SirCrashAlot79/lathe_dro/Case lid.stl

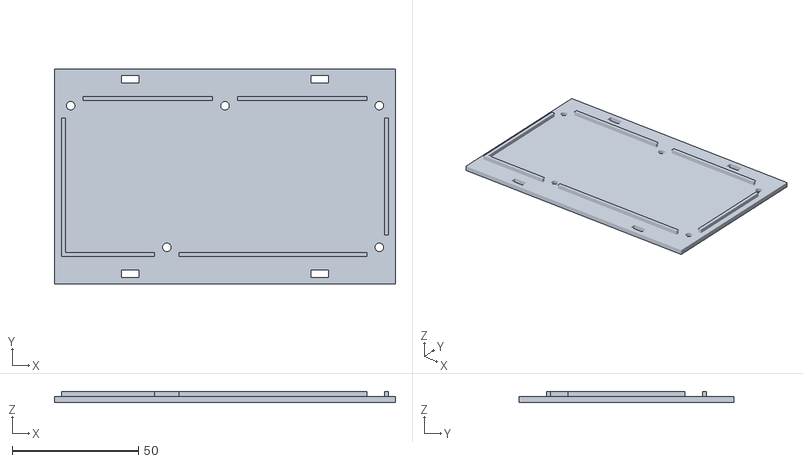
[picture p5: CAD file, 2026-10-19]
Case lid.stl
134.8 x 84.8 x 4.40
