SirCrashAlot79/lathe_dro/Right frame.stl

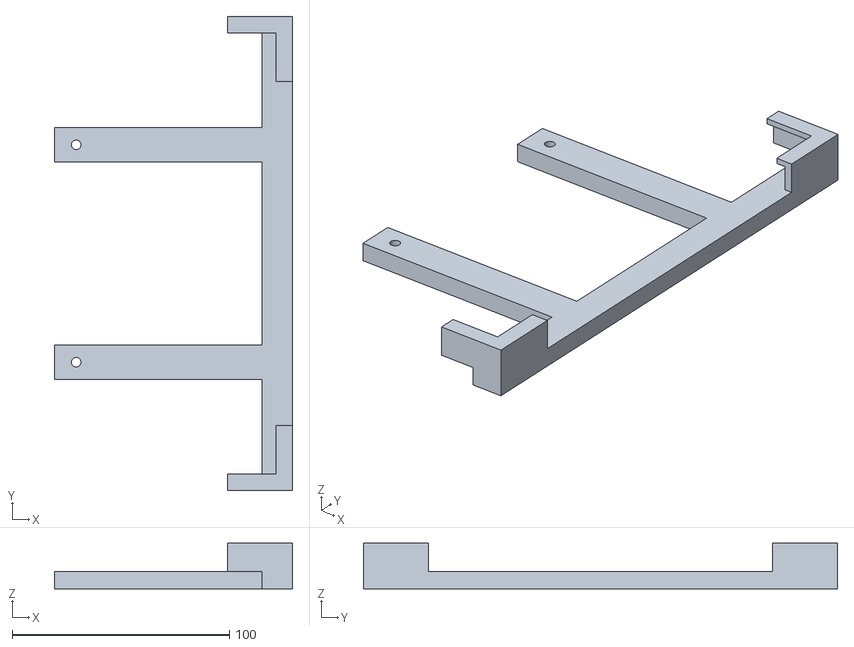
[picture p6: CAD file, 2026-10-19]
Right frame.stl
109.5 x 218.0 x 21.0
