SirCrashAlot79/lathe_dro/Case base.stl

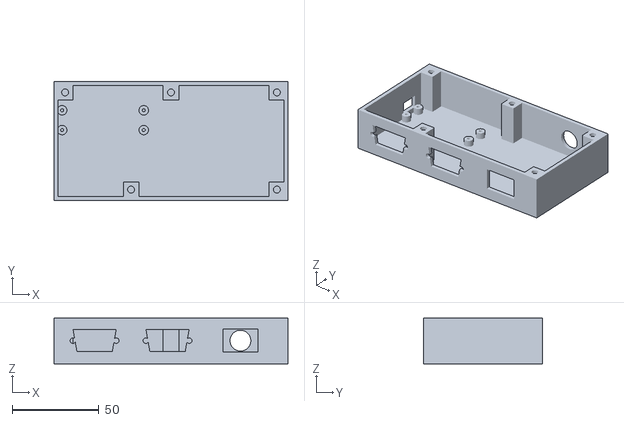
[picture p7: CAD file, 2026-10-19]
Case base.stl
134.8 x 68.8 x 26.4
