SirCrashAlot79/lathe_dro/(list of files, cad)

Other CAD files:
Left frame.stl
