SirCrashAlot79/lathe_dro/raspberry_pi_dro/lathe_dro_pro.py

import argparse
import json
import math
from pathlib import Path
import subprocess
import sys
import pygame
import serial
from serial.tools import list_ports

# --- CONFIGURATION INITIALIZATION ---
PULSES_PER_INCH = 25400.0
DEMO_MODE = False
TOOL_OFFSETS_FILE = Path(__file__).with_name("tool_offsets.json")
SCALE_CALIBRATION_FILE = Path(__file__).with_name("scale_calibration.json")
MILL_SCALE_CALIBRATION_FILE = Path(__file__).with_name("mill_scale_calibration.json")
MILL_SUB_DATUMS_FILE = Path(__file__).with_name("mill_sub_datums.json")
BOOT_IMAGE_FILE = Path(__file__).with_name("assets") / "south_bend_badge.png"
STUD_GEAR = 40
THREADING_CHART = (
    ("A", (4, 4.5, 5, 5.5, 5.75, 6, 6.5, 6.75, 7, 7.5)),
    ("B", (8, 9, 10, 11, 11.5, 12, 13, 13.5, 14, 15)),
    ("C", (16, 18, 20, 22, 23, 24, 26, 27, 28, 30)),
    ("D", (32, 36, 40, 44, 46, 48, 52, 54, 56, 60)),
    ("E", (64, 72, 80, 88, 92, 96, 104, 108, 112, 120)),
    ("F", (128, 144, 160, 176, 184, 192, 208, 216, 224, 240)),
    ("G", (256, 288, 320, 352, 368, 384, 416, 432, 448, 480)),
)
HSS_SURFACE_SPEED_SFM = {
    "Mild steel": 80,
    "Aluminum": 200,
    "Stainless steel": 50,
    "Cast iron": 60,
}
SPINDLE_SPEED_STEPS = {
    ("BELT DRIVE", "LOW RANGE"): (240, 410, 715),
    ("BACK GEAR", "LOW RANGE"): (50, 78, 135),
    ("BELT DRIVE", "HIGH RANGE"): (460, 780, 1365),
    ("BACK GEAR", "HIGH RANGE"): (90, 155, 265),
}


def parse_serial_packet(line):
    """Parse separate lathe/mill counts or a legacy shared-axis packet."""
    if not line.strip():
        return 0, 0, 0, 0, 0, 0

    values = {}
    for field in line.strip().split(","):
        key, value = field.split(":", 1)
        values[key.strip().upper()] = int(value.strip())

    if {"LX", "LZ", "MX", "MY", "MZ", "RPM"}.issubset(values):
        return (
            values["LX"],
            values["LZ"],
            values["MX"],
            values["MY"],
            values["MZ"],
            values["RPM"],
        )

    try:
        x_count = values["X"]
        z_count = values["Z"]
        y_count = values.get("Y", 0)
        rpm_count = values["RPM"]
    except KeyError as error:
        raise ValueError(f"Missing {error.args[0]} field in serial packet") from error
    return x_count, z_count, x_count, y_count, z_count, rpm_count


def counts_for_machine(machine, lathe_counts, mill_counts):
    if machine == "lathe":
        return lathe_counts[0], 0, lathe_counts[1]
    if machine == "mill":
        return mill_counts
    raise ValueError(f"Unknown machine: {machine}")


def find_pico_port():
    for port in list_ports.comports():
        description = (port.description or "").lower()
        if port.vid == 0x2E8A or "pico" in description:
            return port.device
    return None


def read_serial_packets(connection, pending_data):
    if connection is None or not connection.in_waiting:
        return pending_data, None

    pending_data += connection.read(connection.in_waiting).decode("ascii", errors="ignore")
    latest_packet = None
    while "\n" in pending_data:
        line, pending_data = pending_data.split("\n", 1)
        if not line.strip():
            continue
        try:
            latest_packet = parse_serial_packet(line)
        except (ValueError, KeyError):
            continue
    if len(pending_data) > 1024:
        pending_data = pending_data[-1024:]
    return pending_data, latest_packet


def open_pico_connection(port, baudrate):
    selected_port = port or find_pico_port()
    if selected_port is None:
        return None, "Pico not found; use --port or --demo"
    try:
        return serial.Serial(selected_port, baudrate=baudrate, timeout=0), f"Connected: {selected_port}"
    except serial.SerialException as error:
        return None, f"Serial connection failed: {error}"


def load_tool_touch_positions(path=TOOL_OFFSETS_FILE):
    try:
        data = json.loads(path.read_text(encoding="utf-8"))
    except (OSError, json.JSONDecodeError):
        return {}
    if not isinstance(data, dict):
        return {}

    positions = {}
    for tool_id, coordinates in data.items():
        try:
            tool_id = int(tool_id)
            x_position = int(coordinates["x"])
            z_position = int(coordinates["z"])
        except (KeyError, TypeError, ValueError):
            continue
        if 1 <= tool_id <= 9:
            positions[tool_id] = (x_position, z_position)
    return positions


def save_tool_touch_positions(path, positions):
    data = {
        str(tool_id): {"x": x_position, "z": z_position}
        for tool_id, (x_position, z_position) in positions.items()
    }
    path.write_text(json.dumps(data, indent=2) + "\n", encoding="utf-8")


def scale_compensation_for_travel(known_distance, count_delta,
                                  metric=False, pulses_per_inch=PULSES_PER_INCH):
    """Return the correction factor from a measured linear-axis move."""
    values = (known_distance, count_delta, pulses_per_inch)
    if not all(math.isfinite(value) for value in values):
        raise ValueError("calibration values must be finite numbers")
    if known_distance <= 0 or count_delta == 0 or pulses_per_inch <= 0:
        raise ValueError("distance, count change, and counts per inch must be positive")

    distance_inches = known_distance / 25.4 if metric else known_distance
    return distance_inches * pulses_per_inch / abs(count_delta)


def load_scale_calibration(path=SCALE_CALIBRATION_FILE):
    factors = {"x": 1.0, "y": 1.0, "z": 1.0}
    try:
        data = json.loads(path.read_text(encoding="utf-8"))
    except (OSError, json.JSONDecodeError):
        return factors
    if not isinstance(data, dict):
        return factors

    for axis in factors:
        try:
            factor = float(data.get(axis, factors[axis]))
        except (TypeError, ValueError):
            continue
        if math.isfinite(factor) and factor > 0:
            factors[axis] = factor
    return factors


def save_scale_calibration(path, factors):
    data = {axis: float(factors[axis]) for axis in ("x", "y", "z")}
    path.write_text(json.dumps(data, indent=2) + "\n", encoding="utf-8")


def set_scale_compensation(axis, factor, path=SCALE_CALIBRATION_FILE):
    """Persist a valid per-axis correction and update the live display factor."""
    global x_linear_error_comp, y_linear_error_comp, z_linear_error_comp
    global scale_calibration_factors

    axis = axis.upper()
    if axis not in ("X", "Y", "Z") or not math.isfinite(factor) or factor <= 0:
        raise ValueError("axis must be X, Y, or Z and compensation must be positive")
    updated_factors = dict(scale_calibration_factors)
    updated_factors[axis.lower()] = float(factor)
    save_scale_calibration(path, updated_factors)
    scale_calibration_factors = updated_factors
    if axis == "X":
        x_linear_error_comp = updated_factors["x"]
    elif axis == "Y":
        y_linear_error_comp = updated_factors["y"]
    else:
        z_linear_error_comp = updated_factors["z"]


def set_mill_scale_compensation(axis, factor, path=MILL_SCALE_CALIBRATION_FILE):
    """Persist independent per-axis mill calibration."""
    global mill_scale_calibration_factors

    axis = axis.lower()
    if axis not in ("x", "y", "z") or not math.isfinite(factor) or factor <= 0:
        raise ValueError("axis must be X, Y, or Z and compensation must be positive")
    updated_factors = dict(mill_scale_calibration_factors)
    updated_factors[axis] = float(factor)
    save_scale_calibration(path, updated_factors)
    mill_scale_calibration_factors = updated_factors


def mill_preset_origin(count, preset_value, compensation, metric=False,
                       direction=1, pulses_per_inch=PULSES_PER_INCH):
    """Return the raw count origin that produces a requested mill coordinate."""
    if direction not in (-1, 1):
        raise ValueError("axis direction must be 1 or -1")
    values = (count, preset_value, compensation, pulses_per_inch)
    if not all(math.isfinite(value) for value in values):
        raise ValueError("preset and calibration values must be finite")
    if compensation <= 0 or pulses_per_inch <= 0:
        raise ValueError("calibration factor and counts per inch must be positive")

    distance_inches = preset_value / 25.4 if metric else preset_value
    preset_counts = round(distance_inches * pulses_per_inch / compensation)
    return int(count) - direction * preset_counts


def mill_half_origin(count, origin):
    """Shift a mill axis origin so the current coordinate reads half its value."""
    return int(count) - round((int(count) - int(origin)) / 2)


def load_mill_sub_datums(path=MILL_SUB_DATUMS_FILE):
    try:
        data = json.loads(path.read_text(encoding="utf-8"))
    except FileNotFoundError:
        return {}
    except json.JSONDecodeError as error:
        raise ValueError("Sub-datum file contains invalid JSON") from error

    if not isinstance(data, dict):
        raise ValueError("Sub-datum file must contain an object")

    datums = {}
    for name, coordinates in data.items():
        if not isinstance(name, str) or not name or not isinstance(coordinates, dict):
            raise ValueError("Each sub-datum must have a name and X/Y/Z coordinates")
        if set(coordinates) != {"X", "Y", "Z"}:
            raise ValueError(f"Sub-datum {name} must contain X, Y, and Z")
        if any(not isinstance(coordinates[axis], int) for axis in ("X", "Y", "Z")):
            raise ValueError(f"Sub-datum {name} coordinates must be integer counts")
        datums[name] = dict(coordinates)
    return datums


def save_mill_sub_datums(path, datums):
    for name, coordinates in datums.items():
        if (not name or set(coordinates) != {"X", "Y", "Z"}
                or any(not isinstance(coordinates[axis], int) for axis in ("X", "Y", "Z"))):
            raise ValueError("Sub-datums require a name and integer X/Y/Z counts")
    path.write_text(json.dumps(datums, indent=2) + "\n", encoding="utf-8")


def tool_x_offset_to_counts(offset, metric=False, diameter_mode=False,
                            linear_error_comp=1.0, pulses_per_inch=PULSES_PER_INCH):
    """Convert a displayed, signed X tool offset to raw encoder counts."""
    values = (offset, linear_error_comp, pulses_per_inch)
    if not all(math.isfinite(value) for value in values):
        raise ValueError("tool offset and calibration values must be finite")
    if linear_error_comp <= 0 or pulses_per_inch <= 0:
        raise ValueError("calibration factor and counts per inch must be positive")

    radial_distance = offset / 2.0 if diameter_mode else offset
    distance_inches = radial_distance / 25.4 if metric else radial_distance
    return round(distance_inches * pulses_per_inch / linear_error_comp)


def tool_offset_for(tool_id, positions):
    reference = positions.get(1)
    tool_position = positions.get(tool_id)
    if reference is None or tool_position is None:
        return None
    return tool_position[0] - reference[0], tool_position[1] - reference[1]


def tool_corrected_x_count(x_pulses, tool_id, positions):
    offset = tool_offset_for(tool_id, positions)
    if offset is None:
        return None
    return x_pulses - offset[0]


def tool_position_with_manual_x_offset(tool_id, offset_counts, positions):
    """Build a tool's count position from its signed offset to the T-1 master."""
    if not isinstance(tool_id, int) or not 2 <= tool_id <= 9:
        raise ValueError("manual X offsets require a tool ID from T-2 through T-9")
    master_position = positions.get(1)
    if master_position is None:
        raise ValueError("capture T-1 master reference first")
    current_position = positions.get(tool_id)
    z_count = current_position[1] if current_position is not None else master_position[1]
    return master_position[0] + int(offset_counts), z_count

if __name__ == "__main__":
    argument_parser = argparse.ArgumentParser(description="Lathe and mill digital readout")
    argument_parser.add_argument("--port", help="Pico USB serial port, for example /dev/ttyACM0")
    argument_parser.add_argument("--baud", type=int, default=115200)
    argument_parser.add_argument("--demo", action="store_true", help="Use simulated readings")
    display_group = argument_parser.add_mutually_exclusive_group()
    display_group.add_argument("--fullscreen", dest="fullscreen", action="store_true")
    display_group.add_argument("--windowed", dest="fullscreen", action="store_false")
    argument_parser.set_defaults(fullscreen=sys.platform.startswith("linux"))
    arguments = argument_parser.parse_args()

    pygame.init()
    if arguments.fullscreen:
        display_screen = pygame.display.set_mode((0, 0), pygame.FULLSCREEN)
    else:
        display_screen = pygame.display.set_mode((1280, 720))
    pygame.display.set_caption("South Bend Lathe / Grizzly G0704 Mill DRO")
    width, height = 1280, 720
    screen = pygame.Surface((width, height))
    display_width, display_height = display_screen.get_size()
    ui_scale = min(display_width / width, display_height / height)
    viewport_width = int(width * ui_scale)
    viewport_height = int(height * ui_scale)
    viewport_left = (display_width - viewport_width) // 2
    viewport_top = (display_height - viewport_height) // 2
    font_large = pygame.font.SysFont("courier", int(height * 0.13), bold=True)
    font_medium = pygame.font.SysFont("sans", int(height * 0.05), bold=True)
    font_small = pygame.font.SysFont("sans", int(height * 0.032))
    font_button = pygame.font.SysFont("sans", int(height * 0.027))
    boot_logo = pygame.image.load(BOOT_IMAGE_FILE).convert_alpha()
    boot_logo_width = 260
    boot_logo_height = round(boot_logo_width * boot_logo.get_height() / boot_logo.get_width())
    boot_logo = pygame.transform.smoothscale(
        boot_logo, (boot_logo_width, boot_logo_height)
    )
else:
    display_screen = None
    screen = None
    width, height = 1280, 720
    ui_scale = 1.0
    viewport_left = 0
    viewport_top = 0

# --- THEME STYLING ---
BLACK = (11, 15, 17)
GREY = (20, 27, 29)
MED_GREY = (31, 40, 42)
LIGHT_GREY = (82, 96, 98)
CYAN = (95, 190, 202)
YELLOW = (235, 174, 72)
WHITE = (225, 230, 226)
GREEN = (137, 194, 132)
MAGENTA = (78, 155, 166)
RED = (208, 78, 68)


def draw_industrial_background(target, target_width, target_height):
    target.fill(BLACK)
    for y in range(28, target_height - 12, 32):
        pygame.draw.line(target, (15, 20, 22), (0, y), (target_width, y), 1)
    pygame.draw.rect(target, (25, 33, 35), (0, 0, target_width, 12))
    pygame.draw.line(target, YELLOW, (0, 12), (target_width, 12), 2)
    pygame.draw.line(target, LIGHT_GREY, (0, target_height - 10), (target_width, target_height - 10), 2)
    pygame.draw.rect(target, (7, 10, 12), (0, target_height - 8, target_width, 8))
    pygame.draw.line(target, (48, 60, 62), (14, 20), (14, target_height - 20), 2)


def wrap_text(text, font, max_width):
    lines = []
    for paragraph in text.splitlines() or [""]:
        current_line = ""
        for word in paragraph.split():
            candidate = word if not current_line else f"{current_line} {word}"
            if font.size(candidate)[0] <= max_width:
                current_line = candidate
                continue
            if current_line:
                lines.append(current_line)
                current_line = ""
            if font.size(word)[0] <= max_width:
                current_line = word
                continue
            fragment = ""
            for character in word:
                if fragment and font.size(fragment + character)[0] > max_width:
                    lines.append(fragment)
                    fragment = character
                else:
                    fragment += character
            current_line = fragment
        lines.append(current_line)
    return lines


def draw_wrapped_text(target, text, font, color, position, max_width, line_gap=3):
    x_position, y_position = position
    for line in wrap_text(text, font, max_width):
        surface = font.render(line, True, color)
        target.blit(surface, (x_position, y_position))
        y_position += surface.get_height() + line_gap
    return y_position


def font_small_rect(font, text, rect):
    return font.render(text, True, WHITE).get_rect(center=rect.center)


def screen_text_rect(font, text, rect):
    return font.render(text, True, BLACK).get_rect(center=rect.center)


def draw_choice_button(screen, rect, label, font):
    pygame.draw.rect(screen, MED_GREY, rect)
    pygame.draw.rect(screen, WHITE, rect, 2)
    screen.blit(font.render(label, True, WHITE), font_small_rect(font, label, rect))


def draw_clear_button(screen, rect, font):
    draw_choice_button(screen, rect, "CLEAR ACTIVE FIELD", font)


def draw_numeric_sign_button(screen, font):
    draw_choice_button(screen, NUMERIC_SIGN_BUTTON, "± SIGN", font)


def draw_back_button(screen, rect, font):
    pygame.draw.rect(screen, RED, rect)
    pygame.draw.rect(screen, WHITE, rect, 2)
    screen.blit(font.render("BACK", True, WHITE), font_small_rect(font, "BACK", rect))


# --- APP STATES ---
STATE_MAIN_DRO = 0
STATE_SETUP_MENU = 1
STATE_TOOL_SETUP = 2
STATE_BOOT = 3
STATE_TAPER = 4
STATE_THREAD = 5
STATE_SPEED = 6
STATE_COORD = 7
STATE_BORING = 8
STATE_POWER_CONFIRM = 9
STATE_MACHINE_SELECT = 10
STATE_MILL_DRO = 11
STATE_MILL_PRESET = 12
STATE_MILL_TOOLS = 13
STATE_MILL_CUTTER_COMP = 14
STATE_MILL_CALCULATOR = 15
STATE_MILL_DATUMS = 16
BOOT_DURATION_MS = 2500
current_state = STATE_BOOT
setup_return_state = STATE_MAIN_DRO

# --- SYSTEM & CALIBRATION CALCULATION REGISTERS ---
lathe_x_pulses, lathe_z_pulses = 0, 0
mill_x_pulses, mill_y_pulses, mill_z_pulses = 0, 0, 0
x_pulses, y_pulses, z_pulses, rpm = 0, 0, 0, 0
selected_machine = "lathe"
x_abs_zero, y_abs_zero, z_abs_zero = 0, 0, 0
x_inc_zero, y_inc_zero, z_inc_zero = 0, 0, 0
mill_abs_zero = {"X": 0, "Y": 0, "Z": 0}
mill_work_zero = {"X": 0, "Y": 0, "Z": 0}
mill_inc_zero = {"X": 0, "Y": 0, "Z": 0}
mill_sub_datums = {}
mill_active_sub_datum = "WORK"
mill_datum_slot = 1
mill_datum_status = ""
mill_datum_file_status = ""
mill_calculator_mode = "STANDARD"
mill_calculator_operation = "+"
mill_calculator_values = {"first": "", "second": ""}
mill_calculator_status = ""
mill_calculator_function_index = 0
MILL_CALCULATOR_FUNCTIONS = ("+", "-", "*", "/", "SIN", "COS", "TAN", "ASIN", "ACOS", "ATAN")
mill_cutter_side = "LEFT"
mill_cutter_values = {"x": "", "y": "", "diameter": "", "angle": ""}
mill_cutter_active_field = "x"
mill_calculator_active_field = "first"
mill_calculator_operation_index = 0
tool_touch_positions = load_tool_touch_positions()
manual_tool_x_offset_text = ""
manual_tool_x_offset_tool_id = None
manual_tool_x_offset_sign = 1
is_diameter_mode = True
is_metric = False
is_abs_mode = True
mill_is_abs_mode = True
current_tool_id = 1
operation_mode = "TURNING"
boring_initial_diameter = ""
boring_start_x_counts = None
boring_start_tool_id = None
boring_start_tool_offset = None
boring_direction = 1
boring_metric = False
boring_status = ""

# User Adjustable Parameters via Setup Panel
resolution_tier = 0.0005     # Toggles: 0.0001, 0.0005, 0.0010
scale_calibration_factors = load_scale_calibration()
x_linear_error_comp = scale_calibration_factors["x"]
y_linear_error_comp = scale_calibration_factors["y"]
z_linear_error_comp = scale_calibration_factors["z"]
mill_scale_calibration_factors = load_scale_calibration(MILL_SCALE_CALIBRATION_FILE)
mill_is_metric = False
mill_axis_direction = {"X": 1, "Y": 1, "Z": 1}
mill_preset_axis = "X"
mill_preset_text = ""
mill_preset_negative = False
mill_preset_status = ""
coord_return_state = STATE_MAIN_DRO
scale_calibration_state = {
    profile: {
        "distances": {"X": "", "Y": "", "Z": ""},
        "start_counts": {"X": None, "Y": None, "Z": None},
        "active_axis": "X",
    }
    for profile in ("lathe", "mill")
}
scale_calibration_status = ""
backlash_x = 0.0000          # For mechanical backlash storage

def round_to_precision(value, metric_mode, resolution=0.0005):
    """Dynamically steps values according to active resolution constraints."""
    if metric_mode:
        return round(value, 3)
    if resolution <= 0:
        raise ValueError("resolution must be greater than zero")
    steps_per_inch = 1.0 / resolution
    return round(value * steps_per_inch) / steps_per_inch


def compound_rest_angle(large_diameter, small_diameter, taper_length):
    dimensions = (large_diameter, small_diameter, taper_length)
    if not all(math.isfinite(value) for value in dimensions):
        raise ValueError("dimensions must be finite numbers")
    if large_diameter < 0 or small_diameter < 0 or taper_length <= 0:
        raise ValueError("diameters must be non-negative and length must be positive")
    return math.degrees(math.atan(abs(large_diameter - small_diameter) / (2 * taper_length)))


def thread_setting_for(tpi):
    try:
        requested_tpi = float(tpi)
    except (TypeError, ValueError) as error:
        raise ValueError("TPI must be a positive number") from error
    if not math.isfinite(requested_tpi) or requested_tpi <= 0:
        raise ValueError("TPI must be a positive number")

    for tumbler, pitches in THREADING_CHART:
        for column, chart_tpi in enumerate(pitches, start=1):
            if math.isclose(requested_tpi, chart_tpi, rel_tol=0, abs_tol=1e-9):
                return {
                    "tpi": chart_tpi,
                    "stud_gear": STUD_GEAR,
                    "tumbler": tumbler,
                    "selector_column": column,
                }
    return None


def spindle_rpm_for_surface_speed(diameter, surface_speed_sfm, metric=False):
    if not math.isfinite(diameter) or not math.isfinite(surface_speed_sfm):
        raise ValueError("diameter and surface speed must be finite numbers")
    if diameter <= 0 or surface_speed_sfm <= 0:
        raise ValueError("diameter and surface speed must be positive")
    diameter_inches = diameter / 25.4 if metric else diameter
    return 12 * surface_speed_sfm / (math.pi * diameter_inches)


def recommend_spindle_step(target_rpm, drive_mode, speed_range):
    try:
        target_rpm = float(target_rpm)
    except (TypeError, ValueError) as error:
        raise ValueError("target RPM must be positive") from error
    if not math.isfinite(target_rpm) or target_rpm <= 0:
        raise ValueError("target RPM must be positive")
    try:
        available_speeds = SPINDLE_SPEED_STEPS[(drive_mode, speed_range)]
    except KeyError as error:
        raise ValueError("unknown spindle drive or range") from error

    safe_steps = [
        (step_number, rpm)
        for step_number, rpm in enumerate(available_speeds, start=1)
        if rpm <= target_rpm
    ]
    if not safe_steps:
        return None
    step_number, rpm = safe_steps[-1]
    return {
        "step": step_number,
        "rpm": rpm,
        "spindle": ("largest", "middle", "smallest")[step_number - 1],
        "at_maximum": step_number == len(available_speeds),
    }


def coordinate_midpoint(first, second):
    if not math.isfinite(first) or not math.isfinite(second):
        raise ValueError("coordinates must be finite numbers")
    return (first + second) / 2


def shoulder_distance(first, second):
    if not math.isfinite(first) or not math.isfinite(second):
        raise ValueError("coordinates must be finite numbers")
    return abs(second - first)


def boring_hole_diameter(initial_diameter, initial_x_counts, current_x_counts,
                         increasing_direction=1, metric=False,
                         pulses_per_inch=PULSES_PER_INCH, linear_error_comp=1.0):
    values = (initial_diameter, initial_x_counts, current_x_counts, pulses_per_inch, linear_error_comp)
    if not all(math.isfinite(value) for value in values):
        raise ValueError("boring inputs must be finite numbers")
    if initial_diameter < 0 or pulses_per_inch <= 0 or linear_error_comp <= 0:
        raise ValueError("diameter must be non-negative and calibration values positive")
    if increasing_direction not in (-1, 1):
        raise ValueError("increasing direction must be 1 or -1")

    radial_travel_inches = (current_x_counts - initial_x_counts) / pulses_per_inch
    radial_travel_inches *= linear_error_comp * increasing_direction
    diameter_increase = radial_travel_inches * 2
    if metric:
        diameter_increase *= 25.4
    return initial_diameter + diameter_increase


def request_system_poweroff():
    try:
        result = subprocess.run(
            ["sudo", "-n", "/usr/bin/systemctl", "poweroff"],
            capture_output=True,
            text=True,
            timeout=10,
        )
    except (OSError, subprocess.TimeoutExpired) as error:
        return False, str(error)
    if result.returncode != 0:
        message = (result.stderr or result.stdout or "Power-off request was denied.").strip()
        return False, message[:160]
    return True, ""


def bolt_circle_coordinates(pitch_circle_diameter, hole_count, start_angle_degrees=0,
                            center_x=0.0, center_y=0.0):
    values = (pitch_circle_diameter, start_angle_degrees, center_x, center_y)
    if not all(math.isfinite(value) for value in values):
        raise ValueError("bolt-circle dimensions must be finite numbers")
    if pitch_circle_diameter <= 0 or not isinstance(hole_count, int) or hole_count < 2:
        raise ValueError("PCD must be positive and hole count must be an integer of at least 2")

    radius = pitch_circle_diameter / 2
    return [
        (
            center_x + radius * math.cos(math.radians(start_angle_degrees + index * 360 / hole_count)),
            center_y + radius * math.sin(math.radians(start_angle_degrees + index * 360 / hole_count)),
        )
        for index in range(hole_count)
    ]


def linear_hole_coordinates(start_x, start_y, hole_count, pitch, angle_degrees=0):
    values = (start_x, start_y, pitch, angle_degrees)
    if not all(math.isfinite(value) for value in values):
        raise ValueError("linear pattern values must be finite")
    if not isinstance(hole_count, int) or not 2 <= hole_count <= 24:
        raise ValueError("linear pattern must contain 2 to 24 holes")
    if pitch <= 0:
        raise ValueError("hole pitch must be positive")

    angle = math.radians(angle_degrees)
    return [
        (
            start_x + index * pitch * math.cos(angle),
            start_y + index * pitch * math.sin(angle),
        )
        for index in range(hole_count)
    ]


def grid_hole_coordinates(start_x, start_y, rows, columns, step_x, step_y,
                          angle_degrees=0):
    values = (start_x, start_y, step_x, step_y, angle_degrees)
    if not all(math.isfinite(value) for value in values):
        raise ValueError("grid values must be finite")
    if (not isinstance(rows, int) or not isinstance(columns, int)
            or rows < 1 or columns < 1 or rows * columns > 24):
        raise ValueError("grid must contain 1 to 24 holes")
    if (rows > 1 and step_y <= 0) or (columns > 1 and step_x <= 0):
        raise ValueError("grid step must be positive when that dimension has multiple holes")

    angle = math.radians(angle_degrees)
    cos_angle, sin_angle = math.cos(angle), math.sin(angle)
    return [
        (
            start_x + column * step_x * cos_angle - row * step_y * sin_angle,
            start_y + column * step_x * sin_angle + row * step_y * cos_angle,
        )
        for row in range(rows)
        for column in range(columns)
    ]


def cutter_radius_compensated_point(x, y, cutter_diameter, path_angle_degrees,
                                    side="LEFT"):
    values = (x, y, cutter_diameter, path_angle_degrees)
    if not all(math.isfinite(value) for value in values):
        raise ValueError("cutter compensation values must be finite")
    if cutter_diameter <= 0:
        raise ValueError("cutter diameter must be positive")
    side = side.upper()
    if side not in ("LEFT", "RIGHT"):
        raise ValueError("cutter side must be LEFT or RIGHT")

    normal_angle = math.radians(path_angle_degrees + (90 if side == "LEFT" else -90))
    radius = cutter_diameter / 2
    return x + radius * math.cos(normal_angle), y + radius * math.sin(normal_angle)


def standard_calculation(first, second, operation):
    values = (first, second)
    if not all(math.isfinite(value) for value in values):
        raise ValueError("calculator values must be finite")
    operations = {
        "+": lambda: first + second,
        "-": lambda: first - second,
        "*": lambda: first * second,
        "/": lambda: first / second,
    }
    if operation not in operations:
        raise ValueError("unknown calculator operation")
    if operation == "/" and second == 0:
        raise ValueError("cannot divide by zero")
    return operations[operation]()


def trigonometric_calculation(function, value):
    if not math.isfinite(value):
        raise ValueError("trigonometric input must be finite")
    functions = {
        "SIN": lambda angle: math.sin(math.radians(angle)),
        "COS": lambda angle: math.cos(math.radians(angle)),
        "TAN": lambda angle: math.tan(math.radians(angle)),
        "ASIN": lambda ratio: math.degrees(math.asin(ratio)),
        "ACOS": lambda ratio: math.degrees(math.acos(ratio)),
        "ATAN": lambda ratio: math.degrees(math.atan(ratio)),
    }
    function = function.upper()
    if function not in functions:
        raise ValueError("unknown trigonometric function")
    if function in ("ASIN", "ACOS") and not -1 <= value <= 1:
        raise ValueError(f"{function} input must be between -1 and 1")
    if function == "TAN" and math.isclose(math.cos(math.radians(value)), 0, abs_tol=1e-12):
        raise ValueError("tangent is undefined at this angle")
    return functions[function](value)


def slope_calculation(rise, run):
    if not math.isfinite(rise) or not math.isfinite(run):
        raise ValueError("slope values must be finite")
    if run == 0:
        raise ValueError("run must not be zero")
    ratio = rise / run
    return ratio, ratio * 100, math.degrees(math.atan(ratio))


COORD_MODE_FIELDS = {
    "MIDPOINT": ("first", "second"),
    "DISTANCE": ("first", "second"),
    "BOLT CIRCLE": ("center_x", "center_y", "pcd", "holes", "start"),
    "LINEAR ARRAY": ("start_x", "start_y", "holes", "pitch", "angle"),
    "GRID": ("start_x", "start_y", "rows", "columns", "step_x", "step_y", "angle"),
}


def coordinate_fields_for_mode(mode):
    try:
        field_names = COORD_MODE_FIELDS[mode]
    except KeyError as error:
        raise ValueError(f"Unknown coordinate mode: {mode}") from error
    return {
        name: pygame.Rect(45 + index % 2 * 300, 225 + index // 2 * 63, 270, 50)
        for index, name in enumerate(field_names)
    }

# --- UI INTERACTION BOUNDARIES ---
panel_x = int(width * 0.75)
btn_w = int(width * 0.11)
btn_h = int(height * 0.12)
col1_x = panel_x + 10
col2_x = panel_x + btn_w + 20
header_button_gap = 8
header_button_width = max(70, int((width - panel_x - 30 - 2 * header_button_gap) / 3))
header_button_start = panel_x + 10
header_button_y = 20
header_button_height = max(72, int(height * 0.085))
operation_button_gap = 12
operation_button_width = max(240, min(360, int(width * 0.20)))

main_buttons = {
    "TURNING": pygame.Rect(40, 20, operation_button_width, header_button_height),
    "BORING": pygame.Rect(40 + operation_button_width + operation_button_gap, 20, operation_button_width, header_button_height),
    "DIA": pygame.Rect(header_button_start, header_button_y, header_button_width, header_button_height),
    "INCH/MM": pygame.Rect(header_button_start + header_button_width + header_button_gap, header_button_y, header_button_width, header_button_height),
    "POWER": pygame.Rect(header_button_start + 2 * (header_button_width + header_button_gap), header_button_y, header_button_width, header_button_height),
    "MACHINES": pygame.Rect(40 + 2 * (operation_button_width + operation_button_gap), 20, operation_button_width, header_button_height),
    "ZERO_X":  pygame.Rect(col1_x, int(height*0.16), btn_w, btn_h),
    "ABS/INC": pygame.Rect(col2_x, int(height*0.16), btn_w, btn_h),
    "ZERO_Z":  pygame.Rect(col1_x, int(height*0.30), btn_w, btn_h),
    "TOOL_LIB":pygame.Rect(col2_x, int(height*0.30), btn_w, btn_h),
    "TOOL_SETUP": pygame.Rect(col1_x, int(height*0.44), btn_w, btn_h),
    "FEED":    pygame.Rect(col2_x, int(height*0.44), btn_w, btn_h),
    "TAPER":   pygame.Rect(col1_x, int(height*0.58), btn_w, btn_h),
    "SPEED":   pygame.Rect(col2_x, int(height*0.58), btn_w, btn_h),
    "COORD":   pygame.Rect(col1_x, int(height*0.72), btn_w, btn_h),
    "SETUP":   pygame.Rect(col2_x, int(height*0.72), btn_w, btn_h)
}
machine_select_buttons = {
    "LATHE": pygame.Rect(105, 230, 470, 340),
    "MILL": pygame.Rect(705, 230, 470, 340),
}
mill_header_buttons = {
    "INCH/MM": pygame.Rect(45, 28, 230, 70),
    "ABS/INC": pygame.Rect(295, 28, 230, 70),
    "SETUP": pygame.Rect(545, 28, 230, 70),
    "MACROS": pygame.Rect(795, 28, 180, 70),
    "MACHINES": pygame.Rect(width - 285, 28, 240, 70),
}
mill_tools_buttons = {
    "COORDINATES": pygame.Rect(60, 150, 500, 100),
    "CUTTER COMP": pygame.Rect(650, 150, 500, 100),
    "CALCULATOR": pygame.Rect(60, 300, 500, 100),
    "SUB-DATUMS": pygame.Rect(650, 300, 500, 100),
    "BACK": pygame.Rect(width - 350, height - 120, 300, 80),
}
mill_macro_functions = ("PCD", "LINEAR ARRAY", "GRID", "MIDPOINT", "DISTANCE")
mill_pattern_mode_buttons = {
    name: pygame.Rect(45 + index % 3 * 205, 95 + index // 3 * 68, 190, 54)
    for index, name in enumerate(mill_macro_functions)
}
coord_mode_buttons = mill_pattern_mode_buttons
mill_cutter_fields = {
    "x": pygame.Rect(50, 170, 490, 65),
    "y": pygame.Rect(50, 270, 490, 65),
    "diameter": pygame.Rect(50, 370, 490, 65),
    "angle": pygame.Rect(50, 470, 490, 65),
}
mill_cutter_side_button = pygame.Rect(50, 560, 490, 60)
mill_calc_mode_buttons = {
    name: pygame.Rect(50 + index * 205, 95, 190, 55)
    for index, name in enumerate(("STANDARD", "TRIG", "SLOPE"))
}
mill_calc_operation_button = pygame.Rect(50, 390, 180, 60)
mill_calc_function_button = pygame.Rect(50, 390, 300, 60)
mill_datum_slots = {
    index: pygame.Rect(50, 130 + (index - 1) * 62, 720, 54)
    for index in range(1, 9)
}
mill_datum_actions = {
    "SAVE": pygame.Rect(820, 150, 350, 70),
    "USE": pygame.Rect(820, 245, 350, 70),
    "DELETE": pygame.Rect(820, 340, 350, 70),
    "BACK": pygame.Rect(width - 350, height - 120, 300, 80),
}
mill_axis_rows = {
    axis: pygame.Rect(35, 120 + index * 180, 900, 165)
    for index, axis in enumerate(("X", "Y", "Z"))
}
mill_zero_buttons = {
    axis: pygame.Rect(645, 120 + index * 180 + 50, 65, 60)
    for index, axis in enumerate(("X", "Y", "Z"))
}
mill_half_buttons = {
    axis: pygame.Rect(715, 120 + index * 180 + 50, 65, 60)
    for index, axis in enumerate(("X", "Y", "Z"))
}
mill_preset_buttons = {
    axis: pygame.Rect(785, 120 + index * 180 + 50, 65, 60)
    for index, axis in enumerate(("X", "Y", "Z"))
}
mill_direction_buttons = {
    axis: pygame.Rect(855, 120 + index * 180 + 50, 65, 60)
    for index, axis in enumerate(("X", "Y", "Z"))
}
mill_preset_buttons_panel = {
    "SIGN": pygame.Rect(50, 300, 180, 60),
    "SET": pygame.Rect(50, 385, 280, 70),
    "CANCEL": pygame.Rect(350, 385, 280, 70),
}

boring_input_rect = pygame.Rect(50, 165, 500, 70)
boring_buttons = {
    "TURNING": pygame.Rect(40, 20, 230, 54),
    "CAPTURE": pygame.Rect(50, 275, 500, 75),
    "DIRECTION": pygame.Rect(50, 370, 500, 60),
}
boring_readout_width = int(width * 0.115)
boring_readout_gap = int(width * 0.008)
boring_readout_start = width - 20 - 3 * boring_readout_width - 2 * boring_readout_gap
boring_readout_rects = {
    name: pygame.Rect(boring_readout_start + index * (boring_readout_width + boring_readout_gap), 20, boring_readout_width, 56)
    for index, name in enumerate(("X", "Z", "RPM"))
}
boring_zero_buttons = {
    "X": pygame.Rect(boring_readout_rects["X"].x, 84, boring_readout_width, 38),
    "Z": pygame.Rect(boring_readout_rects["Z"].x, 84, boring_readout_width, 38),
}
boring_tool_button = pygame.Rect(boring_readout_rects["RPM"].x, 84, boring_readout_width, 38)

setup_buttons = {
    "RES_TOGGLE": pygame.Rect(50, 90, 300, 60),
    "CAL_X_DISTANCE": pygame.Rect(50, 180, 140, 48),
    "CAL_X_START": pygame.Rect(205, 180, 160, 48),
    "CAL_X_APPLY": pygame.Rect(375, 180, 180, 48),
    "COMP_X_UP": pygame.Rect(570, 230, 60, 36),
    "COMP_X_DN": pygame.Rect(635, 230, 60, 36),
    "CAL_Y_DISTANCE": pygame.Rect(50, 315, 140, 48),
    "CAL_Y_START": pygame.Rect(205, 315, 160, 48),
    "CAL_Y_APPLY": pygame.Rect(375, 315, 180, 48),
    "COMP_Y_UP": pygame.Rect(570, 365, 60, 36),
    "COMP_Y_DN": pygame.Rect(635, 365, 60, 36),
    "CAL_Z_DISTANCE": pygame.Rect(50, 450, 140, 48),
    "CAL_Z_START": pygame.Rect(205, 450, 160, 48),
    "CAL_Z_APPLY": pygame.Rect(375, 450, 180, 48),
    "COMP_Z_UP": pygame.Rect(570, 500, 60, 36),
    "COMP_Z_DN": pygame.Rect(635, 500, 60, 36),
    "BACK_MAIN":  pygame.Rect(width - 350, height - 120, 300, 80)
}

power_confirm_buttons = {
    "CANCEL": pygame.Rect(width // 2 - 260, int(height * 0.70), 220, 80),
    "CONFIRM": pygame.Rect(width // 2 + 40, int(height * 0.70), 260, 80)
}

tool_setup_buttons = {
    "PREVIOUS": pygame.Rect(60, 215, 140, 70),
    "NEXT": pygame.Rect(220, 215, 140, 70),
    "CAPTURE": pygame.Rect(60, 325, 300, 80),
    "X_OFFSET_FIELD": pygame.Rect(50, 620, 270, 54),
    "X_OFFSET_SIGN": pygame.Rect(330, 620, 90, 54),
    "X_OFFSET_APPLY": pygame.Rect(430, 620, 280, 54),
    "BACK": pygame.Rect(width - 350, height - 120, 300, 80)
}
tool_readout_width = int(width * 0.18)
tool_readout_gap = int(width * 0.02)
tool_readout_start = width - 2 * tool_readout_width - tool_readout_gap - 24
tool_readout_rects = {
    "X": pygame.Rect(tool_readout_start, 30, tool_readout_width, 82),
    "Z": pygame.Rect(tool_readout_start + tool_readout_width + tool_readout_gap, 30, tool_readout_width, 82)
}
tool_zero_buttons = {
    "X": pygame.Rect(tool_readout_rects["X"].x, 130, tool_readout_width, 52),
    "Z": pygame.Rect(tool_readout_rects["Z"].x, 130, tool_readout_width, 52)
}
tool_offset_keypad_buttons = {}
tool_offset_keypad_x = 800
tool_offset_keypad_y = 198
tool_offset_keypad_w = 108
tool_offset_keypad_h = 48
tool_offset_keypad_gap_x = 10
tool_offset_keypad_gap_y = 8
for tool_keypad_index, tool_keypad_key in enumerate(("7", "8", "9", "4", "5", "6", "1", "2", "3", ".", "0", "DEL")):
    tool_keypad_row, tool_keypad_column = divmod(tool_keypad_index, 3)
    tool_offset_keypad_buttons[tool_keypad_key] = pygame.Rect(
        tool_offset_keypad_x + tool_keypad_column * (tool_offset_keypad_w + tool_offset_keypad_gap_x),
        tool_offset_keypad_y + tool_keypad_row * (tool_offset_keypad_h + tool_offset_keypad_gap_y),
        tool_offset_keypad_w,
        tool_offset_keypad_h,
    )
tool_offset_clear_button = pygame.Rect(
    tool_offset_keypad_x,
    tool_offset_keypad_y + 4 * (tool_offset_keypad_h + tool_offset_keypad_gap_y),
    3 * tool_offset_keypad_w + 2 * tool_offset_keypad_gap_x,
    48,
)

taper_values = {"large": "", "small": "", "length": ""}
active_taper_field = "large"
taper_fields = {
    "large": pygame.Rect(50, 150, 500, 70),
    "small": pygame.Rect(50, 265, 500, 70),
    "length": pygame.Rect(50, 380, 500, 70)
}
keypad_keys = ("7", "8", "9", "4", "5", "6", "1", "2", "3", ".", "0", "DEL")
keypad_buttons = {}
keypad_x = int(width * 0.57)
keypad_y = int(height * 0.20)
keypad_w = int(width * 0.10)
keypad_h = int(height * 0.09)
keypad_gap_x = int(width * 0.012)
keypad_gap_y = int(height * 0.018)
for keypad_index, keypad_key in enumerate(keypad_keys):
    keypad_row, keypad_column = divmod(keypad_index, 3)
    keypad_buttons[keypad_key] = pygame.Rect(
        keypad_x + keypad_column * (keypad_w + keypad_gap_x),
        keypad_y + keypad_row * (keypad_h + keypad_gap_y),
        keypad_w,
        keypad_h
    )
taper_buttons = {
    "CLEAR": pygame.Rect(keypad_x, keypad_y + 4 * (keypad_h + keypad_gap_y), 3 * keypad_w + 2 * keypad_gap_x, 55),
    "BACK": pygame.Rect(width - 350, height - 120, 300, 80)
}
thread_input = ""
thread_input_rect = pygame.Rect(50, 170, 500, 80)
thread_buttons = {
    "CLEAR": taper_buttons["CLEAR"],
    "BACK": taper_buttons["BACK"]
}
speed_material_names = tuple(HSS_SURFACE_SPEED_SFM)
speed_material_index = 0
speed_values = {"diameter": "", "sfm": str(HSS_SURFACE_SPEED_SFM[speed_material_names[0]])}
active_speed_field = "diameter"
speed_fields = {
    "diameter": pygame.Rect(50, 170, 500, 70),
    "sfm": pygame.Rect(50, 300, 500, 70)
}
speed_material_button = pygame.Rect(50, 390, 500, 50)
speed_drive_button = pygame.Rect(50, 450, 500, 55)
speed_range_button = pygame.Rect(50, 515, 500, 55)
speed_drive_mode = "BELT DRIVE"
speed_range_mode = "LOW RANGE"
speed_buttons = {
    "CLEAR": taper_buttons["CLEAR"],
    "BACK": taper_buttons["BACK"]
}
coord_mode = "MIDPOINT"
coord_values = {
    "first": "", "second": "",
    "center_x": "", "center_y": "", "pcd": "", "holes": "", "start": "0",
    "start_x": "", "start_y": "", "pitch": "", "angle": "0",
    "rows": "", "columns": "", "step_x": "", "step_y": "",
}
COORD_INPUT_MAX_LENGTH = {
    key: 12 for key in coord_values
}
COORD_INPUT_MAX_LENGTH.update({"holes": 2, "rows": 2, "columns": 2})
active_coord_field = "first"
coord_buttons = {
    "CLEAR": taper_buttons["CLEAR"],
    "BACK": taper_buttons["BACK"]
}
NUMERIC_SIGN_BUTTON = pygame.Rect(
    keypad_x,
    keypad_y + 4 * (keypad_h + keypad_gap_y) + 60,
    3 * keypad_w + 2 * keypad_gap_x,
    48,
)

serial_connection = None
serial_buffer = ""
connection_status = "Disconnected"
poweroff_status = ""
if __name__ == "__main__":
    DEMO_MODE = arguments.demo
    if DEMO_MODE:
        connection_status = "DEMO MODE"
    else:
        serial_connection, connection_status = open_pico_connection(arguments.port, arguments.baud)
    running = True
    boot_started_ms = pygame.time.get_ticks()
else:
    running = False
    boot_started_ms = 0

clock = pygame.time.Clock() if running else None
frame_counter = 0

while running:
    frame_counter += 1

    # 1. READ INTERACTION TARGETING BASED ON VIEW STATE
    pos = (0, 0)
    clicked = False

    for event in pygame.event.get():
        if event.type == pygame.QUIT or (event.type == pygame.KEYDOWN and event.key == pygame.K_ESCAPE):
            running = False
        elif event.type == pygame.MOUSEBUTTONDOWN:
            display_x, display_y = event.pos
            if (viewport_left <= display_x < viewport_left + viewport_width and
                    viewport_top <= display_y < viewport_top + viewport_height):
                pos = (
                    int((display_x - viewport_left) / ui_scale),
                    int((display_y - viewport_top) / ui_scale),
                )
                clicked = True

    # 2. RUN SIMULATED HARDWARE FEEDBACK ENGINE
    if DEMO_MODE:
        if frame_counter % 2 == 0:
            lathe_x_pulses += int(10 * math.sin(frame_counter / 60.0))
            lathe_z_pulses += int(35 * math.cos(frame_counter / 120.0))
            mill_x_pulses += int(10 * math.sin(frame_counter / 60.0))
            mill_y_pulses += int(20 * math.sin(frame_counter / 90.0))
            mill_z_pulses += int(35 * math.cos(frame_counter / 120.0))
        rpm = int(720 + (12 * math.sin(frame_counter / 15.0)))
    elif serial_connection is not None:
        try:
            serial_buffer, packet = read_serial_packets(serial_connection, serial_buffer)
            if packet is not None:
                (
                    lathe_x_pulses,
                    lathe_z_pulses,
                    mill_x_pulses,
                    mill_y_pulses,
                    mill_z_pulses,
                    rpm,
                ) = packet
        except serial.SerialException:
            connection_status = "Serial connection lost"
            serial_connection.close()
            serial_connection = None

    x_pulses, y_pulses, z_pulses = counts_for_machine(
        selected_machine,
        (lathe_x_pulses, lathe_z_pulses),
        (mill_x_pulses, mill_y_pulses, mill_z_pulses),
    )

    # 3. EVALUATE WINDOW EXECUTION STATES
    if current_state == STATE_BOOT:
        elapsed_ms = pygame.time.get_ticks() - boot_started_ms
        if elapsed_ms >= BOOT_DURATION_MS:
            current_state = STATE_MACHINE_SELECT
        else:
            draw_industrial_background(screen, width, height)
            center_x = width // 2
            screen.blit(boot_logo, boot_logo.get_rect(center=(center_x, int(height * 0.34))))
            subtitle = font_medium.render("MACHINE DIGITAL READOUT", True, YELLOW)
            screen.blit(subtitle, subtitle.get_rect(center=(center_x, int(height * 0.58))))

            boot_status = "DEMO STARTING" if DEMO_MODE else "CONNECTING TO PICO"
            status_text = font_small.render(boot_status, True, CYAN)
            screen.blit(status_text, status_text.get_rect(center=(center_x, int(height * 0.68))))

            bar_width = int(width * 0.46)
            bar_height = max(8, int(height * 0.014))
            bar_x = (width - bar_width) // 2
            bar_y = int(height * 0.76)
            pygame.draw.rect(screen, GREY, (bar_x, bar_y, bar_width, bar_height), border_radius=2)
            fill_width = int(bar_width * elapsed_ms / BOOT_DURATION_MS)
            pygame.draw.rect(screen, CYAN, (bar_x, bar_y, fill_width, bar_height), border_radius=2)
    elif current_state == STATE_MACHINE_SELECT:
        if clicked:
            if machine_select_buttons["LATHE"].collidepoint(pos):
                selected_machine = "lathe"
                current_state = STATE_MAIN_DRO
            elif machine_select_buttons["MILL"].collidepoint(pos):
                selected_machine = "mill"
                current_state = STATE_MILL_DRO

        draw_industrial_background(screen, width, height)
        title = font_medium.render("SELECT MACHINE", True, YELLOW)
        screen.blit(title, title.get_rect(center=(width // 2, 125)))
        lathe_rect = machine_select_buttons["LATHE"]
        pygame.draw.rect(screen, MED_GREY, lathe_rect)
        pygame.draw.rect(screen, YELLOW, lathe_rect, 3)
        screen.blit(boot_logo, boot_logo.get_rect(center=(lathe_rect.centerx, lathe_rect.centery - 35)))
        lathe_label = font_small.render("SOUTH BEND LATHE DRO", True, WHITE)
        screen.blit(lathe_label, lathe_label.get_rect(center=(lathe_rect.centerx, lathe_rect.bottom - 42)))

        mill_rect = machine_select_buttons["MILL"]
        pygame.draw.rect(screen, MED_GREY, mill_rect)
        pygame.draw.rect(screen, CYAN, mill_rect, 3)
        mill_label = font_medium.render("Grizzly G0704 Mill", True, WHITE)
        screen.blit(mill_label, mill_label.get_rect(center=mill_rect.center))

        hint = font_small.render("Select a machine to open its readout", True, LIGHT_GREY)
        screen.blit(hint, hint.get_rect(center=(width // 2, height - 60)))
    elif current_state == STATE_MILL_TOOLS:
        if clicked:
            if mill_tools_buttons["COORDINATES"].collidepoint(pos):
                coord_return_state = STATE_MILL_DRO
                current_state = STATE_COORD
            elif mill_tools_buttons["CUTTER COMP"].collidepoint(pos):
                current_state = STATE_MILL_CUTTER_COMP
            elif mill_tools_buttons["CALCULATOR"].collidepoint(pos):
                current_state = STATE_MILL_CALCULATOR
            elif mill_tools_buttons["SUB-DATUMS"].collidepoint(pos):
                try:
                    mill_sub_datums = load_mill_sub_datums()
                    mill_datum_file_status = ""
                except (OSError, ValueError) as error:
                    mill_datum_file_status = str(error)
                current_state = STATE_MILL_DATUMS
            elif mill_tools_buttons["BACK"].collidepoint(pos):
                current_state = STATE_MILL_DRO

        draw_industrial_background(screen, width, height)
        screen.blit(font_medium.render("MILL ADVANCED & MACRO FUNCTIONS", True, YELLOW), (50, 45))
        for name, rect in mill_tools_buttons.items():
            color = RED if name == "BACK" else MED_GREY
            pygame.draw.rect(screen, color, rect)
            pygame.draw.rect(screen, WHITE, rect, 2)
            label = "BACK" if name == "BACK" else name
            text = font_small.render(label, True, WHITE)
            screen.blit(text, text.get_rect(center=rect.center))
        draw_wrapped_text(
            screen,
            "Coordinate patterns calculate numbered hole positions; they never move the mill.",
            font_small, LIGHT_GREY, (60, 465), 1100,
        )

    elif current_state == STATE_POWER_CONFIRM:
        if clicked:
            if power_confirm_buttons["CONFIRM"].collidepoint(pos):
                poweroff_succeeded, poweroff_status = request_system_poweroff()
                if poweroff_succeeded:
                    running = False
            elif power_confirm_buttons["CANCEL"].collidepoint(pos):
                current_state = STATE_MAIN_DRO

        draw_industrial_background(screen, width, height)
        prompt = font_medium.render("SHUT DOWN COMPUTER?", True, YELLOW)
        screen.blit(prompt, prompt.get_rect(center=(width // 2, int(height * 0.40))))
        detail = font_small.render("The DRO will close and Ubuntu will power off.", True, WHITE)
        screen.blit(detail, detail.get_rect(center=(width // 2, int(height * 0.49))))
        if poweroff_status:
            draw_wrapped_text(screen, poweroff_status, font_small, RED, (70, int(height * 0.55)), width - 140)
        for key, label, color in (("CANCEL", "CANCEL", MED_GREY), ("CONFIRM", "SHUT DOWN", RED)):
            rect = power_confirm_buttons[key]
            pygame.draw.rect(screen, color, rect)
            pygame.draw.rect(screen, LIGHT_GREY, rect, 2)
            text = font_small.render(label, True, WHITE)
            screen.blit(text, text.get_rect(center=rect.center))

    elif current_state == STATE_MAIN_DRO:
        # --- MAIN READOUT DISPLAY SCREEN LOGIC ---
        if clicked:
            if main_buttons["MACHINES"].collidepoint(pos):
                current_state = STATE_MACHINE_SELECT
            elif main_buttons["POWER"].collidepoint(pos):
                current_state = STATE_POWER_CONFIRM
            elif main_buttons["SETUP"].collidepoint(pos):
                setup_return_state = STATE_MAIN_DRO
                current_state = STATE_SETUP_MENU  # SWAP THE SCREEN STATE HERE
            elif main_buttons["TURNING"].collidepoint(pos):
                operation_mode = "TURNING"
            elif main_buttons["BORING"].collidepoint(pos):
                operation_mode = "BORING"
                current_state = STATE_BORING
            elif main_buttons["TOOL_SETUP"].collidepoint(pos):
                current_state = STATE_TOOL_SETUP
            elif main_buttons["TAPER"].collidepoint(pos):
                current_state = STATE_TAPER
            elif main_buttons["FEED"].collidepoint(pos):
                current_state = STATE_THREAD
            elif main_buttons["SPEED"].collidepoint(pos):
                current_state = STATE_SPEED
            elif main_buttons["COORD"].collidepoint(pos):
                coord_return_state = STATE_MAIN_DRO
                current_state = STATE_COORD
            elif main_buttons["DIA"].collidepoint(pos):
                is_diameter_mode = not is_diameter_mode
            elif main_buttons["INCH/MM"].collidepoint(pos):
                is_metric = not is_metric
            elif main_buttons["ABS/INC"].collidepoint(pos):
                is_abs_mode = not is_abs_mode
                if not is_abs_mode:
                    x_inc_zero, z_inc_zero = x_pulses, z_pulses
            elif main_buttons["ZERO_X"].collidepoint(pos):
                if is_abs_mode:
                    offset = tool_offset_for(current_tool_id, tool_touch_positions)
                    x_abs_zero = x_pulses - (offset[0] if offset is not None else 0)
                else:
                    x_inc_zero = x_pulses
            elif main_buttons["ZERO_Z"].collidepoint(pos):
                if is_abs_mode:
                    offset = tool_offset_for(current_tool_id, tool_touch_positions)
                    z_abs_zero = z_pulses - (offset[1] if offset is not None else 0)
                else:
                    z_inc_zero = z_pulses
            elif main_buttons["TOOL_LIB"].collidepoint(pos):
                current_tool_id = 1 if current_tool_id >= 9 else current_tool_id + 1

        # Axis unit processing including Linear Scale Correction parameters
        x_origin = x_abs_zero if is_abs_mode else x_inc_zero
        z_origin = z_abs_zero if is_abs_mode else z_inc_zero
        tool_offset = tool_offset_for(current_tool_id, tool_touch_positions) if is_abs_mode else None
        x_tool_offset, z_tool_offset = tool_offset or (0, 0)
        x_val = ((x_pulses - x_origin - x_tool_offset) / PULSES_PER_INCH) * x_linear_error_comp
        z_val = ((z_pulses - z_origin - z_tool_offset) / PULSES_PER_INCH) * z_linear_error_comp

        if is_metric:
            x_val *= 25.4
            z_val *= 25.4
        if is_diameter_mode:
            x_val *= 2.0

        x_display = round_to_precision(x_val, is_metric, resolution_tier)
        z_display = round_to_precision(z_val, is_metric, resolution_tier)
        fmt = "0.3f" if is_metric else "0.4f"

        # DRAW MAIN HUD STAGE
        draw_industrial_background(screen, width, height)
        pygame.draw.line(screen, GREY, (0, int(height*0.33)), (panel_x, int(height*0.33)), 4)
        pygame.draw.line(screen, GREY, (0, int(height*0.66)), (panel_x, int(height*0.66)), 4)
        pygame.draw.line(screen, GREY, (panel_x, 0), (panel_x, height), 4)

        x_value_y = max(int(height * 0.145), header_button_y + header_button_height + 8)
        screen.blit(font_medium.render("X", True, WHITE), (40, int(x_value_y + height * 0.04)))
        screen.blit(font_large.render(format(x_display, fmt), True, CYAN), (150, x_value_y))
        screen.blit(font_medium.render("Z", True, WHITE), (40, int(height * 0.41)))
        screen.blit(font_large.render(format(z_display, fmt), True, WHITE), (150, int(height * 0.37)))
        screen.blit(font_medium.render("SPINDLE SPEED", True, WHITE), (40, int(height * 0.68)))
        screen.blit(font_large.render(f"{rpm} RPM", True, GREEN), (40, int(height * 0.74)))
        status_color = GREEN if DEMO_MODE or serial_connection is not None else RED
        screen.blit(font_small.render(connection_status, True, status_color), (40, int(height * 0.94)))

        # DRAW SIDEBAR INTERACTIVE TILES
        for btn_name, rect in main_buttons.items():
            b_color = GREY
            t_color = WHITE
            if btn_name == "TURNING" and operation_mode == "TURNING": b_color, t_color = YELLOW, BLACK
            elif btn_name == "BORING" and operation_mode == "BORING": b_color, t_color = YELLOW, BLACK
            elif btn_name == "DIA": b_color, t_color = YELLOW, BLACK
            elif btn_name == "INCH/MM": b_color, t_color = MAGENTA, BLACK
            elif btn_name == "ABS/INC": b_color, t_color = CYAN, BLACK
            elif btn_name in ("SETUP", "TOOL_SETUP", "POWER", "MACHINES"): b_color, t_color = RED, WHITE

            pygame.draw.rect(screen, b_color, rect)
            pygame.draw.rect(screen, LIGHT_GREY, rect, 2)
            if btn_name == "DIA":
                label_text = "DIA" if is_diameter_mode else "RAD"
            elif btn_name in ("TURNING", "BORING"):
                label_text = btn_name
            elif btn_name == "INCH/MM":
                label_text = "MM" if is_metric else "INCH"
            elif btn_name == "ABS/INC":
                label_text = "ABS" if is_abs_mode else "INC"
            elif btn_name == "TOOL_SETUP":
                label_text = "TOOL SET"
            elif btn_name == "MACHINES":
                label_text = "MACHINES"
            else:
                label_text = f"T-{current_tool_id}" if btn_name == "TOOL_LIB" else btn_name
            lbl = font_small.render(label_text, True, t_color)
            screen.blit(lbl, lbl.get_rect(center=rect.center))

    elif current_state == STATE_MILL_DRO:
        if clicked:
            if mill_header_buttons["MACHINES"].collidepoint(pos):
                current_state = STATE_MACHINE_SELECT
            elif mill_header_buttons["INCH/MM"].collidepoint(pos):
                mill_is_metric = not mill_is_metric
            elif mill_header_buttons["ABS/INC"].collidepoint(pos):
                mill_is_abs_mode = not mill_is_abs_mode
                if not mill_is_abs_mode:
                    mill_inc_zero.update({"X": x_pulses, "Y": y_pulses, "Z": z_pulses})
            elif mill_header_buttons["SETUP"].collidepoint(pos):
                setup_return_state = STATE_MILL_DRO
                current_state = STATE_SETUP_MENU
            elif mill_header_buttons["MACROS"].collidepoint(pos):
                current_state = STATE_MILL_TOOLS
            else:
                current_counts = {"X": x_pulses, "Y": y_pulses, "Z": z_pulses}
                origins = mill_abs_zero if mill_is_abs_mode else mill_inc_zero
                for axis in ("X", "Y", "Z"):
                    if mill_zero_buttons[axis].collidepoint(pos):
                        origins[axis] = current_counts[axis]
                        if mill_is_abs_mode and mill_active_sub_datum == "WORK":
                            mill_work_zero[axis] = current_counts[axis]
                        break
                    if mill_half_buttons[axis].collidepoint(pos):
                        origins[axis] = mill_half_origin(current_counts[axis], origins[axis])
                        break
                    if mill_preset_buttons[axis].collidepoint(pos):
                        mill_preset_axis = axis
                        mill_preset_text = ""
                        mill_preset_negative = False
                        mill_preset_status = ""
                        current_state = STATE_MILL_PRESET
                        break
                    if mill_direction_buttons[axis].collidepoint(pos):
                        mill_axis_direction[axis] *= -1
                        break

        axis_counts = {
            "X": (x_pulses, mill_abs_zero["X"] if mill_is_abs_mode else mill_inc_zero["X"], mill_scale_calibration_factors["x"]),
            "Y": (y_pulses, mill_abs_zero["Y"] if mill_is_abs_mode else mill_inc_zero["Y"], mill_scale_calibration_factors["y"]),
            "Z": (z_pulses, mill_abs_zero["Z"] if mill_is_abs_mode else mill_inc_zero["Z"], mill_scale_calibration_factors["z"]),
        }
        unit = "mm" if mill_is_metric else "in"
        fmt = ".3f" if mill_is_metric else ".4f"
        draw_industrial_background(screen, width, height)

        for key, rect in mill_header_buttons.items():
            pygame.draw.rect(screen, MED_GREY, rect)
            pygame.draw.rect(screen, LIGHT_GREY, rect, 2)
            if key == "INCH/MM":
                label = "MM" if mill_is_metric else "INCH"
            elif key == "ABS/INC":
                label = "ABS" if mill_is_abs_mode else "INC"
            elif key == "SETUP":
                label = "SETUP"
            elif key == "MACROS":
                label = "MACROS"
            else:
                label = "MACHINES"
            text = font_small.render(label, True, WHITE)
            screen.blit(text, text.get_rect(center=rect.center))

        for axis, row in mill_axis_rows.items():
            count, origin, compensation = axis_counts[axis]
            value = (
                (count - origin) / PULSES_PER_INCH
                * compensation * mill_axis_direction[axis]
            )
            if mill_is_metric:
                value *= 25.4
            display_value = round_to_precision(value, mill_is_metric, resolution_tier)
            pygame.draw.rect(screen, GREY, row)
            pygame.draw.rect(screen, LIGHT_GREY, row, 2)
            label = font_medium.render(axis, True, CYAN)
            screen.blit(label, (row.x + 25, row.y + 48))
            readout = font_large.render(f"{display_value:{fmt}}", True, WHITE)
            screen.blit(readout, (row.x + 145, row.y + 30))
            unit_text = font_small.render(unit, True, LIGHT_GREY)
            screen.blit(unit_text, (row.x + 595, row.y + 75))
            for button_rect, label in (
                (mill_zero_buttons[axis], "ZERO"),
                (mill_half_buttons[axis], "HALF"),
                (mill_preset_buttons[axis], "SET"),
                (mill_direction_buttons[axis], "REV" if mill_axis_direction[axis] < 0 else "DIR"),
            ):
                pygame.draw.rect(screen, MED_GREY, button_rect)
                pygame.draw.rect(screen, YELLOW if label != "DIR" else LIGHT_GREY, button_rect, 2)
                button_text = font_button.render(label, True, WHITE)
                screen.blit(button_text, button_text.get_rect(center=button_rect.center))

        status_color = GREEN if DEMO_MODE or serial_connection is not None else RED
        screen.blit(font_small.render(connection_status, True, status_color), (40, height - 42))

    elif current_state == STATE_MILL_CUTTER_COMP:
        if clicked:
            if taper_buttons["BACK"].collidepoint(pos):
                current_state = STATE_MILL_TOOLS
            elif mill_cutter_side_button.collidepoint(pos):
                mill_cutter_side = "RIGHT" if mill_cutter_side == "LEFT" else "LEFT"
            elif taper_buttons["CLEAR"].collidepoint(pos):
                mill_cutter_values[mill_cutter_active_field] = ""
            elif NUMERIC_SIGN_BUTTON.collidepoint(pos):
                value = mill_cutter_values[mill_cutter_active_field]
                mill_cutter_values[mill_cutter_active_field] = value[1:] if value.startswith("-") else "-" + value
            else:
                for field_name, rect in mill_cutter_fields.items():
                    if rect.collidepoint(pos):
                        mill_cutter_active_field = field_name
                        break
                else:
                    for key, rect in keypad_buttons.items():
                        if rect.collidepoint(pos):
                            value = mill_cutter_values[mill_cutter_active_field]
                            if key == "DEL":
                                mill_cutter_values[mill_cutter_active_field] = value[:-1]
                            elif key == ".":
                                if "." not in value:
                                    mill_cutter_values[mill_cutter_active_field] += "."
                            elif len(value) < 12:
                                mill_cutter_values[mill_cutter_active_field] += key
                            break

        draw_industrial_background(screen, width, height)
        screen.blit(font_medium.render("CUTTER RADIUS COMPENSATION", True, YELLOW), (50, 35))
        screen.blit(font_small.render("Enter a nominal part point and the directed straight-edge angle.", True, WHITE), (50, 95))
        cutter_labels = {
            "x": f"NOMINAL X ({'mm' if mill_is_metric else 'in'})",
            "y": f"NOMINAL Y ({'mm' if mill_is_metric else 'in'})",
            "diameter": f"CUTTER DIAMETER ({'mm' if mill_is_metric else 'in'})",
            "angle": "PATH DIRECTION (degrees)",
        }
        for field_name, rect in mill_cutter_fields.items():
            screen.blit(font_small.render(cutter_labels[field_name], True, CYAN), (rect.x, rect.y - 27))
            pygame.draw.rect(screen, MED_GREY, rect)
            pygame.draw.rect(screen, YELLOW if field_name == mill_cutter_active_field else WHITE, rect, 2)
            screen.blit(font_medium.render(mill_cutter_values[field_name] or "Enter", True, WHITE),
                        (rect.x + 14, rect.y + 14))
        pygame.draw.rect(screen, CYAN, mill_cutter_side_button)
        pygame.draw.rect(screen, WHITE, mill_cutter_side_button, 2)
        screen.blit(font_small.render(f"TOOL SIDE: {mill_cutter_side} OF TRAVEL", True, BLACK),
                    screen_text_rect(font_small, f"TOOL SIDE: {mill_cutter_side} OF TRAVEL", mill_cutter_side_button))

        cutter_result = "Enter nominal X/Y, cutter diameter, and path angle."
        cutter_color = WHITE
        if all(mill_cutter_values[name] for name in mill_cutter_fields):
            try:
                compensated_x, compensated_y = cutter_radius_compensated_point(
                    float(mill_cutter_values["x"]),
                    float(mill_cutter_values["y"]),
                    float(mill_cutter_values["diameter"]),
                    float(mill_cutter_values["angle"]),
                    side=mill_cutter_side,
                )
                cutter_result = (
                    f"TOOL CENTER: X {compensated_x:.4f}, Y {compensated_y:.4f} "
                    f"{'mm' if mill_is_metric else 'in'}"
                )
                cutter_color = GREEN
            except ValueError as error:
                cutter_result = str(error)
                cutter_color = RED
        draw_wrapped_text(screen, cutter_result, font_medium, cutter_color, (50, 650), 650)
        draw_wrapped_text(
            screen,
            "Straight-edge offset only; choose travel direction and side carefully. This DRO does not control machine motion.",
            font_small, LIGHT_GREY, (50, 690), 650,
        )
        for key, rect in keypad_buttons.items():
            pygame.draw.rect(screen, MED_GREY, rect)
            pygame.draw.rect(screen, WHITE, rect, 2)
            screen.blit(font_medium.render(key, True, WHITE), font_small_rect(font_medium, key, rect))
        draw_numeric_sign_button(screen, font_small)
        draw_clear_button(screen, taper_buttons["CLEAR"], font_small)
        draw_back_button(screen, taper_buttons["BACK"], font_medium)

    elif current_state == STATE_MILL_CALCULATOR:
        if clicked:
            if taper_buttons["BACK"].collidepoint(pos):
                current_state = STATE_MILL_TOOLS
            elif any(rect.collidepoint(pos) for rect in mill_calc_mode_buttons.values()):
                for mode_name, rect in mill_calc_mode_buttons.items():
                    if rect.collidepoint(pos):
                        mill_calculator_mode = mode_name
                        mill_calculator_status = ""
                        break
            elif mill_calculator_mode == "STANDARD" and mill_calc_operation_button.collidepoint(pos):
                mill_calculator_operation_index = (mill_calculator_operation_index + 1) % 4
            elif mill_calculator_mode == "TRIG" and mill_calc_function_button.collidepoint(pos):
                mill_calculator_function_index = 4 + (mill_calculator_function_index - 3) % 6
            elif taper_buttons["CLEAR"].collidepoint(pos):
                mill_calculator_values[mill_calculator_active_field] = ""
            elif NUMERIC_SIGN_BUTTON.collidepoint(pos):
                value = mill_calculator_values[mill_calculator_active_field]
                mill_calculator_values[mill_calculator_active_field] = value[1:] if value.startswith("-") else "-" + value
            else:
                for field_name, rect in (
                    ("first", pygame.Rect(50, 210, 500, 70)),
                    ("second", pygame.Rect(50, 325, 500, 70)),
                ):
                    if rect.collidepoint(pos) and mill_calculator_mode != "TRIG":
                        mill_calculator_active_field = field_name
                        break
                    if field_name == "first" and rect.collidepoint(pos):
                        mill_calculator_active_field = field_name
                        break
                else:
                    for key, rect in keypad_buttons.items():
                        if rect.collidepoint(pos):
                            value = mill_calculator_values[mill_calculator_active_field]
                            if key == "DEL":
                                mill_calculator_values[mill_calculator_active_field] = value[:-1]
                            elif key == ".":
                                if "." not in value:
                                    mill_calculator_values[mill_calculator_active_field] += "."
                            elif len(value) < 12:
                                mill_calculator_values[mill_calculator_active_field] += key
                            break

        draw_industrial_background(screen, width, height)
        screen.blit(font_medium.render("MILL CALCULATOR / TRIG / SLOPE", True, YELLOW), (50, 35))
        for mode_name, rect in mill_calc_mode_buttons.items():
            pygame.draw.rect(screen, CYAN if mode_name == mill_calculator_mode else MED_GREY, rect)
            pygame.draw.rect(screen, WHITE, rect, 2)
            screen.blit(font_small.render(mode_name, True, BLACK if mode_name == mill_calculator_mode else WHITE),
                        font_small_rect(font_small, mode_name, rect))

        calc_fields = {
            "first": pygame.Rect(50, 210, 500, 70),
            "second": pygame.Rect(50, 325, 500, 70),
        }
        calc_labels = {
            "STANDARD": ("FIRST VALUE", "SECOND VALUE"),
            "TRIG": ("ANGLE / RATIO", ""),
            "SLOPE": ("RISE", "RUN"),
        }[mill_calculator_mode]
        required_fields = ("first",) if mill_calculator_mode == "TRIG" else ("first", "second")
        for field_name, label in zip(required_fields, calc_labels):
            rect = calc_fields[field_name]
            screen.blit(font_small.render(label, True, CYAN), (rect.x, rect.y - 28))
            pygame.draw.rect(screen, MED_GREY, rect)
            pygame.draw.rect(screen, YELLOW if field_name == mill_calculator_active_field else WHITE, rect, 2)
            screen.blit(font_medium.render(mill_calculator_values[field_name] or "Enter", True, WHITE),
                        (rect.x + 14, rect.y + 18))

        if mill_calculator_mode == "STANDARD":
            mill_calculator_operation = ("+", "-", "*", "/")[mill_calculator_operation_index]
            draw_choice_button(screen, mill_calc_operation_button, f"OPERATION: {mill_calculator_operation}", font_small)
        elif mill_calculator_mode == "TRIG":
            function_name = MILL_CALCULATOR_FUNCTIONS[mill_calculator_function_index]
            draw_choice_button(screen, mill_calc_function_button, f"FUNCTION: {function_name}", font_small)
        calc_result = "Enter values to calculate. Trigonometry uses degrees."
        calc_color = WHITE
        if all(mill_calculator_values[name] for name in required_fields):
            try:
                first_value = float(mill_calculator_values["first"])
                if mill_calculator_mode == "STANDARD":
                    result = standard_calculation(
                        first_value, float(mill_calculator_values["second"]),
                        mill_calculator_operation,
                    )
                    calc_result = f"RESULT: {result:.8g}"
                elif mill_calculator_mode == "TRIG":
                    result = trigonometric_calculation(function_name, first_value)
                    suffix = " degrees" if function_name.startswith("A") else ""
                    calc_result = f"{function_name}: {result:.8g}{suffix}"
                else:
                    ratio, percent, angle = slope_calculation(
                        first_value, float(mill_calculator_values["second"])
                    )
                    calc_result = f"SLOPE {ratio:.6g}:1   {percent:.4f}%   ANGLE {angle:.4f} deg"
                calc_color = GREEN
            except ValueError as error:
                calc_result = str(error)
                calc_color = RED
        draw_wrapped_text(screen, calc_result, font_medium, calc_color, (50, 520), 650)
        for key, rect in keypad_buttons.items():
            pygame.draw.rect(screen, MED_GREY, rect)
            pygame.draw.rect(screen, WHITE, rect, 2)
            screen.blit(font_medium.render(key, True, WHITE), font_small_rect(font_medium, key, rect))
        draw_numeric_sign_button(screen, font_small)
        draw_clear_button(screen, taper_buttons["CLEAR"], font_small)
        draw_back_button(screen, taper_buttons["BACK"], font_medium)

    elif current_state == STATE_MILL_DATUMS:
        if clicked:
            for slot, rect in mill_datum_slots.items():
                if rect.collidepoint(pos):
                    mill_datum_slot = slot
                    break
            else:
                slot_name = f"DATUM {mill_datum_slot}"
                if mill_datum_actions["BACK"].collidepoint(pos):
                    current_state = STATE_MILL_TOOLS
                elif mill_datum_actions["SAVE"].collidepoint(pos):
                    if DEMO_MODE or serial_connection is None:
                        mill_datum_status = "Live Pico connection required to capture a sub-datum"
                    else:
                        updated_datums = dict(mill_sub_datums)
                        updated_datums[slot_name] = {"X": x_pulses, "Y": y_pulses, "Z": z_pulses}
                        try:
                            save_mill_sub_datums(MILL_SUB_DATUMS_FILE, updated_datums)
                            mill_sub_datums = updated_datums
                            mill_datum_file_status = ""
                            mill_datum_status = f"{slot_name} saved at current X/Y/Z position"
                        except (OSError, ValueError) as error:
                            mill_datum_status = f"Could not save {slot_name}: {error}"
                elif mill_datum_actions["USE"].collidepoint(pos):
                    if slot_name not in mill_sub_datums:
                        mill_datum_status = f"{slot_name} has not been saved"
                    else:
                        mill_abs_zero.update(mill_sub_datums[slot_name])
                        mill_active_sub_datum = slot_name
                        mill_is_abs_mode = True
                        mill_datum_status = f"{slot_name} selected as the active absolute datum"
                elif mill_datum_actions["DELETE"].collidepoint(pos):
                    if slot_name not in mill_sub_datums:
                        mill_datum_status = f"{slot_name} has not been saved"
                    else:
                        updated_datums = dict(mill_sub_datums)
                        del updated_datums[slot_name]
                        try:
                            save_mill_sub_datums(MILL_SUB_DATUMS_FILE, updated_datums)
                            mill_sub_datums = updated_datums
                            if mill_active_sub_datum == slot_name:
                                mill_active_sub_datum = "WORK"
                                mill_abs_zero.update(mill_work_zero)
                            mill_datum_file_status = ""
                            mill_datum_status = f"{slot_name} deleted"
                        except (OSError, ValueError) as error:
                            mill_datum_status = f"Could not delete {slot_name}: {error}"

        draw_industrial_background(screen, width, height)
        screen.blit(font_medium.render("MILL SUB-DATUMS", True, YELLOW), (50, 35))
        for slot, rect in mill_datum_slots.items():
            is_selected = slot == mill_datum_slot
            pygame.draw.rect(screen, CYAN if is_selected else MED_GREY, rect)
            pygame.draw.rect(screen, YELLOW if is_selected else WHITE, rect, 2)
            slot_name = f"DATUM {slot}"
            saved = mill_sub_datums.get(slot_name)
            summary = (
                f"{slot_name}  X {saved['X']}  Y {saved['Y']}  Z {saved['Z']} counts"
                if saved else f"{slot_name}  (empty)"
            )
            screen.blit(font_small.render(summary, True, BLACK if is_selected else WHITE),
                        (rect.x + 14, rect.y + 15))
        for action, rect in mill_datum_actions.items():
            color = RED if action == "BACK" else MED_GREY
            pygame.draw.rect(screen, color, rect)
            pygame.draw.rect(screen, WHITE, rect, 2)
            screen.blit(font_small.render(action, True, WHITE), font_small_rect(font_small, action, rect))
        active_text = f"Active datum: {mill_active_sub_datum}"
        draw_wrapped_text(screen, active_text, font_small, CYAN, (820, 450), 360)
        status_text = mill_datum_status or mill_datum_file_status
        if status_text:
            draw_wrapped_text(screen, status_text, font_small, YELLOW, (50, 650), 1100)
        draw_wrapped_text(
            screen,
            "Datums store encoder counts. Re-establish the machine reference after the Pico is rebooted.",
            font_small, LIGHT_GREY, (50, 690), 1100,
        )

    elif current_state == STATE_MILL_PRESET:
        if clicked:
            if mill_preset_buttons_panel["CANCEL"].collidepoint(pos):
                current_state = STATE_MILL_DRO
            elif mill_preset_buttons_panel["SIGN"].collidepoint(pos):
                mill_preset_negative = not mill_preset_negative
            elif mill_preset_buttons_panel["SET"].collidepoint(pos):
                try:
                    preset_value = float(mill_preset_text or "0")
                    if mill_preset_negative:
                        preset_value *= -1
                    current_count = {
                        "X": x_pulses, "Y": y_pulses, "Z": z_pulses
                    }[mill_preset_axis]
                    compensation = mill_scale_calibration_factors[mill_preset_axis.lower()]
                    origins = mill_abs_zero if mill_is_abs_mode else mill_inc_zero
                    origins[mill_preset_axis] = mill_preset_origin(
                        current_count,
                        preset_value,
                        compensation,
                        metric=mill_is_metric,
                        direction=mill_axis_direction[mill_preset_axis],
                    )
                    if mill_is_abs_mode and mill_active_sub_datum == "WORK":
                        mill_work_zero[mill_preset_axis] = origins[mill_preset_axis]
                    mill_preset_status = ""
                    current_state = STATE_MILL_DRO
                except ValueError as error:
                    mill_preset_status = str(error)
            elif taper_buttons["CLEAR"].collidepoint(pos):
                mill_preset_text = ""
            else:
                for key, rect in keypad_buttons.items():
                    if rect.collidepoint(pos):
                        if key == "DEL":
                            mill_preset_text = mill_preset_text[:-1]
                        elif key == ".":
                            if "." not in mill_preset_text:
                                mill_preset_text += "."
                        elif len(mill_preset_text) < 12:
                            mill_preset_text += key
                        mill_preset_status = ""
                        break

        draw_industrial_background(screen, width, height)
        screen.blit(
            font_medium.render(f"SET {mill_preset_axis} COORDINATE", True, YELLOW),
            (50, 45),
        )
        screen.blit(
            font_small.render("ENTER PRESET POSITION", True, CYAN),
            (50, 150),
        )
        preset_rect = pygame.Rect(50, 185, 500, 75)
        pygame.draw.rect(screen, MED_GREY, preset_rect)
        pygame.draw.rect(screen, YELLOW, preset_rect, 3)
        sign = "-" if mill_preset_negative else ""
        unit = "mm" if mill_is_metric else "in"
        value_text = font_medium.render(
            f"{sign}{mill_preset_text or '0'} {unit}", True, WHITE
        )
        screen.blit(value_text, value_text.get_rect(midleft=(preset_rect.x + 20, preset_rect.centery)))
        for key, rect in keypad_buttons.items():
            pygame.draw.rect(screen, MED_GREY, rect)
            pygame.draw.rect(screen, WHITE, rect, 2)
            key_text = font_medium.render(key, True, WHITE)
            screen.blit(key_text, key_text.get_rect(center=rect.center))
        for key, label, color in (
            ("SIGN", "+ / -", CYAN),
            ("SET", "SET COORDINATE", GREEN),
            ("CANCEL", "CANCEL", RED),
        ):
            rect = mill_preset_buttons_panel[key]
            pygame.draw.rect(screen, MED_GREY, rect)
            pygame.draw.rect(screen, color, rect, 2)
            button_text = font_button.render(label, True, WHITE)
            screen.blit(button_text, button_text.get_rect(center=rect.center))
        if mill_preset_status:
            draw_wrapped_text(screen, mill_preset_status, font_small, RED, (50, 490), 600)

    elif current_state == STATE_BORING:
        if clicked:
            if boring_buttons["TURNING"].collidepoint(pos):
                operation_mode = "TURNING"
                current_state = STATE_MAIN_DRO
            elif boring_buttons["CAPTURE"].collidepoint(pos):
                if DEMO_MODE:
                    boring_status = "Live Pico readings required for capture"
                elif not boring_initial_diameter:
                    boring_status = "Enter initial drill diameter first"
                else:
                    boring_start_tool_offset = tool_offset_for(current_tool_id, tool_touch_positions)
                    boring_start_x_counts = x_pulses - (boring_start_tool_offset[0] if boring_start_tool_offset else 0)
                    boring_start_tool_id = current_tool_id
                    boring_metric = is_metric
                    boring_status = "Start X captured; bore diameter is live"
            elif boring_buttons["DIRECTION"].collidepoint(pos):
                boring_direction *= -1
                if boring_start_x_counts is not None:
                    boring_status = "X direction changed; recapture the start position"
                    boring_start_x_counts = None
            elif boring_zero_buttons["X"].collidepoint(pos):
                if is_abs_mode:
                    offset = tool_offset_for(current_tool_id, tool_touch_positions)
                    x_abs_zero = x_pulses - (offset[0] if offset is not None else 0)
                else:
                    x_inc_zero = x_pulses
            elif boring_zero_buttons["Z"].collidepoint(pos):
                if is_abs_mode:
                    offset = tool_offset_for(current_tool_id, tool_touch_positions)
                    z_abs_zero = z_pulses - (offset[1] if offset is not None else 0)
                else:
                    z_inc_zero = z_pulses
            elif boring_tool_button.collidepoint(pos):
                next_tool_id = 1 if current_tool_id >= 9 else current_tool_id + 1
                next_tool_offset = tool_offset_for(next_tool_id, tool_touch_positions)
                if boring_start_x_counts is not None and next_tool_id != boring_start_tool_id:
                    if boring_start_tool_offset is None or next_tool_offset is None:
                        boring_start_x_counts = None
                        boring_start_tool_id = None
                        boring_start_tool_offset = None
                        boring_status = "Tool X offset missing; capture X start again"
                    else:
                        boring_status = f"T-{next_tool_id} selected; saved offset retained bore reference"
                current_tool_id = next_tool_id
            elif boring_input_rect.collidepoint(pos):
                pass
            elif taper_buttons["CLEAR"].collidepoint(pos):
                boring_initial_diameter = ""
                boring_start_x_counts = None
                boring_status = ""
            else:
                for key, rect in keypad_buttons.items():
                    if rect.collidepoint(pos):
                        if key == "DEL":
                            boring_initial_diameter = boring_initial_diameter[:-1]
                        elif key == ".":
                            if "." not in boring_initial_diameter:
                                boring_initial_diameter += "."
                        elif len(boring_initial_diameter) < 12:
                            boring_initial_diameter += key
                        boring_start_x_counts = None
                        break

        draw_industrial_background(screen, width, height)
        screen.blit(font_medium.render("CENTER BORING", True, YELLOW), (300, 35))
        x_origin = x_abs_zero if is_abs_mode else x_inc_zero
        z_origin = z_abs_zero if is_abs_mode else z_inc_zero
        tool_offset = tool_offset_for(current_tool_id, tool_touch_positions) if is_abs_mode else None
        x_tool_offset, z_tool_offset = tool_offset or (0, 0)
        x_reading = ((x_pulses - x_origin - x_tool_offset) / PULSES_PER_INCH) * x_linear_error_comp
        z_reading = ((z_pulses - z_origin - z_tool_offset) / PULSES_PER_INCH) * z_linear_error_comp
        if is_metric:
            x_reading *= 25.4
            z_reading *= 25.4
        if is_diameter_mode:
            x_reading *= 2.0
        unit = "mm" if is_metric else "in"
        readout_values = {"X": f"{x_reading:.4f} {unit}", "Z": f"{z_reading:.4f} {unit}", "RPM": f"{rpm}"}
        for name, rect in boring_readout_rects.items():
            pygame.draw.rect(screen, MED_GREY, rect)
            pygame.draw.rect(screen, LIGHT_GREY, rect, 2)
            label = font_small.render(name, True, CYAN if name != "RPM" else GREEN)
            value = font_small.render(readout_values[name], True, WHITE)
            screen.blit(label, (rect.x + 8, rect.y + 3))
            screen.blit(value, (rect.x + 8, rect.y + 29))
        for axis, rect in boring_zero_buttons.items():
            pygame.draw.rect(screen, MED_GREY, rect)
            pygame.draw.rect(screen, LIGHT_GREY, rect, 2)
            zero_text = font_small.render(f"ZERO {axis}", True, WHITE)
            screen.blit(zero_text, zero_text.get_rect(center=rect.center))
        pygame.draw.rect(screen, YELLOW, boring_tool_button)
        pygame.draw.rect(screen, LIGHT_GREY, boring_tool_button, 2)
        tool_text = font_small.render(f"T-{current_tool_id}", True, BLACK)
        screen.blit(tool_text, tool_text.get_rect(center=boring_tool_button.center))

        draw_wrapped_text(screen, "INITIAL HOLE DIAMETER", font_small, CYAN, (50, 125), boring_input_rect.width)
        pygame.draw.rect(screen, MED_GREY, boring_input_rect)
        pygame.draw.rect(screen, YELLOW, boring_input_rect, 3)
        input_text = font_medium.render(f"{boring_initial_diameter or 'Enter diameter'} {unit}", True, WHITE)
        screen.blit(input_text, input_text.get_rect(midleft=(boring_input_rect.x + 20, boring_input_rect.centery)))

        for key, rect in keypad_buttons.items():
            pygame.draw.rect(screen, MED_GREY, rect)
            pygame.draw.rect(screen, WHITE, rect, 2)
            key_text = font_medium.render(key, True, WHITE)
            screen.blit(key_text, key_text.get_rect(center=rect.center))

        capture_rect = boring_buttons["CAPTURE"]
        capture_color = MED_GREY if DEMO_MODE else GREEN
        pygame.draw.rect(screen, capture_color, capture_rect)
        pygame.draw.rect(screen, WHITE, capture_rect, 2)
        capture_label = "LIVE PICO REQUIRED" if DEMO_MODE else "SET X START AT INITIAL BORE SIZE"
        capture_text = font_small.render(capture_label, True, WHITE if DEMO_MODE else BLACK)
        screen.blit(capture_text, capture_text.get_rect(center=capture_rect.center))

        direction_rect = boring_buttons["DIRECTION"]
        pygame.draw.rect(screen, MED_GREY, direction_rect)
        pygame.draw.rect(screen, CYAN, direction_rect, 2)
        direction_label = "X+ INCREASES DIAMETER" if boring_direction > 0 else "X- INCREASES DIAMETER"
        direction_text = font_small.render(direction_label, True, WHITE)
        screen.blit(direction_text, direction_text.get_rect(center=direction_rect.center))

        current_tool_offset = tool_offset_for(current_tool_id, tool_touch_positions)
        if boring_initial_diameter and boring_start_x_counts is not None:
            if current_tool_id == boring_start_tool_id:
                current_boring_x_counts = x_pulses - (current_tool_offset[0] if current_tool_offset else 0)
            elif boring_start_tool_offset is not None and current_tool_offset is not None:
                current_boring_x_counts = tool_corrected_x_count(x_pulses, current_tool_id, tool_touch_positions)
            else:
                current_boring_x_counts = None
            if current_boring_x_counts is None:
                bore_text = "TOOL OFFSET REQUIRED; recapture X start"
                bore_color = RED
            else:
                try:
                    current_bore_diameter = boring_hole_diameter(
                        float(boring_initial_diameter),
                        boring_start_x_counts,
                        current_boring_x_counts,
                        increasing_direction=boring_direction,
                        metric=boring_metric,
                        linear_error_comp=x_linear_error_comp,
                    )
                    bore_text = f"EST. BORE DIAMETER: {current_bore_diameter:.4f} {'mm' if boring_metric else 'in'}"
                    bore_color = GREEN
                except ValueError as error:
                    bore_text = str(error)
                    bore_color = RED
        elif boring_initial_diameter:
            bore_text = f"READY TO CAPTURE START: {boring_initial_diameter} {unit}"
            bore_color = WHITE
        else:
            bore_text = "Enter the drilled hole size, then set the X start."
            bore_color = WHITE
        draw_wrapped_text(screen, bore_text, font_medium, bore_color, (50, 475), keypad_x - 70)
        draw_wrapped_text(screen, "Capture X at the start size; bore outward. Verify the estimate with a bore gauge.", font_small, WHITE, (50, 555), keypad_x - 70)
        if boring_status:
            draw_wrapped_text(screen, boring_status, font_small, YELLOW, (50, 620), keypad_x - 70)

        turning_rect = boring_buttons["TURNING"]
        pygame.draw.rect(screen, YELLOW, turning_rect)
        pygame.draw.rect(screen, LIGHT_GREY, turning_rect, 2)
        turning_text = font_small.render("TURNING / BACK", True, BLACK)
        screen.blit(turning_text, turning_text.get_rect(center=turning_rect.center))

    elif current_state == STATE_COORD:
        coord_fields = coordinate_fields_for_mode(coord_mode)
        coord_button_modes = {
            "PCD": "BOLT CIRCLE",
            "LINEAR ARRAY": "LINEAR ARRAY",
            "GRID": "GRID",
            "MIDPOINT": "MIDPOINT",
            "DISTANCE": "DISTANCE",
        }
        if clicked:
            if coord_buttons["BACK"].collidepoint(pos):
                current_state = coord_return_state
            else:
                for button_name, rect in coord_mode_buttons.items():
                    if rect.collidepoint(pos):
                        coord_mode = coord_button_modes[button_name]
                        active_coord_field = COORD_MODE_FIELDS[coord_mode][0]
                        break
                else:
                    for field_name, rect in coord_fields.items():
                        if coord_fields[field_name].collidepoint(pos):
                            active_coord_field = field_name
                            break
                    else:
                        if coord_buttons["CLEAR"].collidepoint(pos):
                            coord_values[active_coord_field] = ""
                        elif NUMERIC_SIGN_BUTTON.collidepoint(pos):
                            value = coord_values[active_coord_field]
                            coord_values[active_coord_field] = value[1:] if value.startswith("-") else "-" + value
                        else:
                            for key, rect in keypad_buttons.items():
                                if rect.collidepoint(pos):
                                    value = coord_values[active_coord_field]
                                    if key == "DEL":
                                        coord_values[active_coord_field] = value[:-1]
                                    elif key == ".":
                                        if active_coord_field != "holes" and "." not in value:
                                            coord_values[active_coord_field] = value + "."
                                    elif len(value) < COORD_INPUT_MAX_LENGTH[active_coord_field]:
                                        coord_values[active_coord_field] = value + key
                                    break

        draw_industrial_background(screen, width, height)
        screen.blit(font_medium.render("MILL COORDINATE / HOLE PATTERN TOOLS", True, YELLOW), (45, 28))
        for button_name, rect in coord_mode_buttons.items():
            selected = coord_button_modes[button_name] == coord_mode
            pygame.draw.rect(screen, CYAN if selected else MED_GREY, rect)
            pygame.draw.rect(screen, WHITE, rect, 2)
            text = font_small.render(button_name, True, BLACK if selected else WHITE)
            screen.blit(text, text.get_rect(center=rect.center))

        coord_is_metric = (
            mill_is_metric if coord_return_state == STATE_MILL_DRO else is_metric
        )
        unit = "mm" if coord_is_metric else "in"
        result_lines = []
        pattern_points = []
        field_labels = {}
        if coord_mode == "BOLT CIRCLE":
            field_labels = {
                "center_x": f"CENTER X ({unit})", "center_y": f"CENTER Y ({unit})",
                "pcd": f"PCD ({unit})", "holes": "HOLE COUNT", "start": "START ANGLE (deg)",
            }
            if all(coord_values[name] for name in COORD_MODE_FIELDS[coord_mode]):
                try:
                    hole_value = float(coord_values["holes"])
                    if not hole_value.is_integer() or hole_value < 2 or hole_value > 24:
                        raise ValueError("Use a whole hole count from 2 to 24")
                    pattern_points = bolt_circle_coordinates(
                        float(coord_values["pcd"]), int(hole_value), float(coord_values["start"]),
                        center_x=float(coord_values["center_x"]),
                        center_y=float(coord_values["center_y"]),
                    )
                except ValueError as error:
                    result_lines = [(str(error), RED)]
        elif coord_mode == "LINEAR ARRAY":
            field_labels = {
                "start_x": f"START X ({unit})", "start_y": f"START Y ({unit})",
                "holes": "HOLE COUNT", "pitch": f"PITCH ({unit})", "angle": "ANGLE (deg)",
            }
            if all(coord_values[name] for name in COORD_MODE_FIELDS[coord_mode]):
                try:
                    hole_value = float(coord_values["holes"])
                    if not hole_value.is_integer():
                        raise ValueError("Hole count must be a whole number")
                    pattern_points = linear_hole_coordinates(
                        float(coord_values["start_x"]), float(coord_values["start_y"]),
                        int(hole_value), float(coord_values["pitch"]), float(coord_values["angle"]),
                    )
                except ValueError as error:
                    result_lines = [(str(error), RED)]
        elif coord_mode == "GRID":
            field_labels = {
                "start_x": f"START X ({unit})", "start_y": f"START Y ({unit})",
                "rows": "ROWS", "columns": "COLUMNS", "step_x": f"X PITCH ({unit})",
                "step_y": f"Y PITCH ({unit})", "angle": "ROTATION (deg)",
            }
            if all(coord_values[name] for name in COORD_MODE_FIELDS[coord_mode]):
                try:
                    rows_value = float(coord_values["rows"])
                    columns_value = float(coord_values["columns"])
                    if not rows_value.is_integer() or not columns_value.is_integer():
                        raise ValueError("Rows and columns must be whole numbers")
                    pattern_points = grid_hole_coordinates(
                        float(coord_values["start_x"]), float(coord_values["start_y"]),
                        int(rows_value), int(columns_value), float(coord_values["step_x"]),
                        float(coord_values["step_y"]), float(coord_values["angle"]),
                    )
                except ValueError as error:
                    result_lines = [(str(error), RED)]
        else:
            field_labels = {
                "first": f"FIRST DRO VALUE ({unit})", "second": f"SECOND DRO VALUE ({unit})"
            }
            if all(coord_values[name] for name in COORD_MODE_FIELDS[coord_mode]):
                try:
                    first_value = float(coord_values["first"])
                    second_value = float(coord_values["second"])
                    if coord_mode == "MIDPOINT":
                        result_lines = [(f"MIDPOINT: {coordinate_midpoint(first_value, second_value):.4f} {unit}", GREEN)]
                    else:
                        result_lines = [(f"SHOULDER DISTANCE: {shoulder_distance(first_value, second_value):.4f} {unit}", GREEN)]
                except ValueError as error:
                    result_lines = [(str(error), RED)]

        for field_name, rect in coord_fields.items():
            label = font_small.render(field_labels[field_name], True, CYAN)
            screen.blit(label, (rect.x, rect.y - 23))
            pygame.draw.rect(screen, MED_GREY, rect)
            pygame.draw.rect(screen, YELLOW if field_name == active_coord_field else WHITE, rect, 2)
            value_text = font_small.render(coord_values[field_name] or "Enter", True, WHITE)
            screen.blit(value_text, value_text.get_rect(center=rect.center))

        for key, rect in keypad_buttons.items():
            pygame.draw.rect(screen, MED_GREY, rect)
            pygame.draw.rect(screen, WHITE, rect, 2)
            key_text = font_medium.render(key, True, WHITE)
            screen.blit(key_text, key_text.get_rect(center=rect.center))
        clear_rect = coord_buttons["CLEAR"]
        pygame.draw.rect(screen, MED_GREY, clear_rect)
        pygame.draw.rect(screen, WHITE, clear_rect, 2)
        clear_text = font_small.render("CLEAR ACTIVE FIELD", True, WHITE)
        screen.blit(clear_text, clear_text.get_rect(center=clear_rect.center))
        draw_numeric_sign_button(screen, font_small)

        if pattern_points:
            for point_index, (x_value, y_value) in enumerate(pattern_points):
                row = point_index // 3
                column = point_index % 3
                point_text = font_small.render(
                    f"{point_index + 1:02d} X{x_value:.3f} Y{y_value:.3f}", True, GREEN
                )
                screen.blit(point_text, (45 + column * 225, 490 + row * 22))
        elif coord_mode in ("BOLT CIRCLE", "LINEAR ARRAY", "GRID"):
            if not result_lines:
                result_lines = [("Enter pattern values to generate coordinates.", WHITE)]
            for line_index, (line, color) in enumerate(result_lines):
                draw_wrapped_text(screen, line, font_small, color, (45, 500 + line_index * 32), 650)
        else:
            if not result_lines:
                result_lines = [("Enter both values to calculate.", WHITE)]
            for line_index, (line, color) in enumerate(result_lines):
                draw_wrapped_text(screen, line, font_small, color, (45, 500 + line_index * 32), 650)
        if coord_mode in ("BOLT CIRCLE", "LINEAR ARRAY", "GRID"):
            draw_wrapped_text(screen, "Coordinates are absolute within the active mill datum; angles are degrees.", font_small, LIGHT_GREY, (45, 680), 670)

        back_rect = coord_buttons["BACK"]
        draw_back_button(screen, back_rect, font_medium)

    elif current_state == STATE_SPEED:
        if clicked:
            if speed_buttons["BACK"].collidepoint(pos):
                current_state = STATE_MAIN_DRO
            elif speed_drive_button.collidepoint(pos):
                speed_drive_mode = "BACK GEAR" if speed_drive_mode == "BELT DRIVE" else "BELT DRIVE"
            elif speed_range_button.collidepoint(pos):
                speed_range_mode = "HIGH RANGE" if speed_range_mode == "LOW RANGE" else "LOW RANGE"
            elif speed_material_button.collidepoint(pos):
                speed_material_index = (speed_material_index + 1) % len(speed_material_names)
                material_name = speed_material_names[speed_material_index]
                speed_values["sfm"] = str(HSS_SURFACE_SPEED_SFM[material_name])
            else:
                for field_name, rect in speed_fields.items():
                    if rect.collidepoint(pos):
                        active_speed_field = field_name
                        break
                else:
                    if speed_buttons["CLEAR"].collidepoint(pos):
                        speed_values[active_speed_field] = ""
                    else:
                        for key, rect in keypad_buttons.items():
                            if rect.collidepoint(pos):
                                value = speed_values[active_speed_field]
                                if key == "DEL":
                                    speed_values[active_speed_field] = value[:-1]
                                elif key == ".":
                                    if "." not in value:
                                        speed_values[active_speed_field] = value + "."
                                elif len(value) < 12:
                                    speed_values[active_speed_field] = value + key
                                break

        draw_industrial_background(screen, width, height)
        screen.blit(font_medium.render("CUTTING SPEED / RPM", True, YELLOW), (50, 35))
        diameter_unit = "mm" if is_metric else "in"
        speed_labels = {"diameter": f"WORK DIAMETER ({diameter_unit})", "sfm": "SURFACE SPEED (SFM)"}
        for field_name, rect in speed_fields.items():
            label = font_small.render(speed_labels[field_name], True, CYAN)
            screen.blit(label, (rect.x, rect.y - 32))
            pygame.draw.rect(screen, MED_GREY, rect)
            pygame.draw.rect(screen, YELLOW if field_name == active_speed_field else WHITE, rect, 3)
            value_text = font_medium.render(speed_values[field_name] or "0", True, WHITE)
            screen.blit(value_text, value_text.get_rect(midleft=(rect.x + 20, rect.centery)))

        pygame.draw.rect(screen, MED_GREY, speed_material_button)
        pygame.draw.rect(screen, WHITE, speed_material_button, 2)
        material_name = speed_material_names[speed_material_index]
        material_text = font_small.render(f"HSS PRESET: {material_name}  {HSS_SURFACE_SPEED_SFM[material_name]} SFM", True, WHITE)
        screen.blit(material_text, material_text.get_rect(center=speed_material_button.center))

        for rect, label in (
            (speed_drive_button, f"DRIVE: {speed_drive_mode}"),
            (speed_range_button, f"RANGE: {speed_range_mode}"),
        ):
            pygame.draw.rect(screen, MED_GREY, rect)
            pygame.draw.rect(screen, CYAN, rect, 2)
            control_text = font_small.render(label, True, WHITE)
            screen.blit(control_text, control_text.get_rect(center=rect.center))

        for key, rect in keypad_buttons.items():
            pygame.draw.rect(screen, MED_GREY, rect)
            pygame.draw.rect(screen, WHITE, rect, 2)
            key_text = font_medium.render(key, True, WHITE)
            screen.blit(key_text, key_text.get_rect(center=rect.center))
        clear_rect = speed_buttons["CLEAR"]
        pygame.draw.rect(screen, MED_GREY, clear_rect)
        pygame.draw.rect(screen, WHITE, clear_rect, 2)
        clear_text = font_small.render("CLEAR ACTIVE FIELD", True, WHITE)
        screen.blit(clear_text, clear_text.get_rect(center=clear_rect.center))

        if speed_values["diameter"] and speed_values["sfm"]:
            try:
                target_rpm = spindle_rpm_for_surface_speed(
                    float(speed_values["diameter"]), float(speed_values["sfm"]), metric=is_metric
                )
                step_recommendation = recommend_spindle_step(target_rpm, speed_drive_mode, speed_range_mode)
                speed_result = f"TARGET: {target_rpm:.0f} RPM"
                speed_result_color = GREEN
                if step_recommendation is None:
                    available = SPINDLE_SPEED_STEPS[(speed_drive_mode, speed_range_mode)]
                    recommendation_text = f"BELOW RANGE: minimum is Step 1 at {available[0]} RPM"
                    recommendation_color = RED
                else:
                    maximum_text = " MAX" if step_recommendation["at_maximum"] else ""
                    recommendation_text = (
                        f"STEP {step_recommendation['step']} / "
                        f"{step_recommendation['spindle'].upper()} PULLEY: "
                        f"{step_recommendation['rpm']} RPM{maximum_text}"
                    )
                    recommendation_color = CYAN
            except ValueError as error:
                speed_result = str(error)
                speed_result_color = RED
                recommendation_text = ""
                recommendation_color = RED
        else:
            speed_result = "Enter work diameter and surface speed."
            speed_result_color = WHITE
            recommendation_text = ""
            recommendation_color = WHITE
        draw_wrapped_text(screen, speed_result, font_small, speed_result_color, (50, 585), keypad_x - 70)
        draw_wrapped_text(screen, recommendation_text, font_small, recommendation_color, (50, 615), keypad_x - 70)
        if speed_drive_mode == "BACK GEAR" and speed_range_mode == "HIGH RANGE":
            note_text = "HIGH-RANGE BACK-GEAR values are starred on the supplied chart; verify its footnote."
        else:
            note_text = "Change belt or engage back gear only with the spindle stopped."
        draw_wrapped_text(screen, note_text, font_small, WHITE, (50, 650), width - 500)
        back_rect = speed_buttons["BACK"]
        pygame.draw.rect(screen, RED, back_rect)
        pygame.draw.rect(screen, WHITE, back_rect, 2)
        back_text = font_medium.render("BACK", True, WHITE)
        screen.blit(back_text, back_text.get_rect(center=back_rect.center))

    elif current_state == STATE_THREAD:
        if clicked:
            if thread_buttons["BACK"].collidepoint(pos):
                current_state = STATE_MAIN_DRO
            elif thread_input_rect.collidepoint(pos):
                pass
            elif thread_buttons["CLEAR"].collidepoint(pos):
                thread_input = ""
            else:
                for key, rect in keypad_buttons.items():
                    if rect.collidepoint(pos):
                        if key == "DEL":
                            thread_input = thread_input[:-1]
                        elif key == ".":
                            if "." not in thread_input:
                                thread_input += "."
                        elif len(thread_input) < 12:
                            thread_input += key
                        break

        draw_industrial_background(screen, width, height)
        screen.blit(font_medium.render("QUICK-CHANGE THREAD CHART", True, YELLOW), (50, 35))
        screen.blit(font_small.render("DESIRED TPI (CHART RANGE: 4-480)", True, CYAN), (50, 125))
        pygame.draw.rect(screen, MED_GREY, thread_input_rect)
        pygame.draw.rect(screen, YELLOW, thread_input_rect, 3)
        tpi_text = font_medium.render(thread_input or "Enter TPI", True, WHITE)
        screen.blit(tpi_text, tpi_text.get_rect(midleft=(thread_input_rect.x + 20, thread_input_rect.centery)))

        for key, rect in keypad_buttons.items():
            pygame.draw.rect(screen, MED_GREY, rect)
            pygame.draw.rect(screen, WHITE, rect, 2)
            key_text = font_medium.render(key, True, WHITE)
            screen.blit(key_text, key_text.get_rect(center=rect.center))

        clear_rect = thread_buttons["CLEAR"]
        pygame.draw.rect(screen, MED_GREY, clear_rect)
        pygame.draw.rect(screen, WHITE, clear_rect, 2)
        clear_text = font_small.render("CLEAR TPI", True, WHITE)
        screen.blit(clear_text, clear_text.get_rect(center=clear_rect.center))

        if not thread_input:
            result_lines = [("Enter a TPI value shown on the gearbox chart.", WHITE)]
        else:
            try:
                setting = thread_setting_for(thread_input)
            except ValueError as error:
                setting = None
                result_lines = [(str(error), RED)]
            else:
                if setting is None:
                    result_lines = [("TPI not listed on this gearbox chart.", RED)]
                else:
                    result_lines = [
                        (f"{setting['tpi']:g} TPI", GREEN),
                        (f"STUD GEAR: {setting['stud_gear']}", WHITE),
                        (f"LEFT-HAND TUMBLER: {setting['tumbler']}", WHITE),
                        (f"RIGHT-HAND SELECTOR: {setting['selector_column']}", WHITE),
                    ]
        result_y = 295
        for line, color in result_lines:
            result_y = draw_wrapped_text(screen, line, font_small, color, (50, result_y), keypad_x - 70, line_gap=2) + 5
        draw_wrapped_text(screen, "Stop spindle before changing gears. Verify the first thread with a pitch gauge.", font_small, WHITE, (50, 535), keypad_x - 70)

        back_rect = thread_buttons["BACK"]
        pygame.draw.rect(screen, RED, back_rect)
        pygame.draw.rect(screen, WHITE, back_rect, 2)
        back_text = font_medium.render("BACK", True, WHITE)
        screen.blit(back_text, back_text.get_rect(center=back_rect.center))

    elif current_state == STATE_TAPER:
        if clicked:
            if taper_buttons["BACK"].collidepoint(pos):
                current_state = STATE_MAIN_DRO
            else:
                for field_name, rect in taper_fields.items():
                    if rect.collidepoint(pos):
                        active_taper_field = field_name
                        break
                else:
                    for key, rect in keypad_buttons.items():
                        if rect.collidepoint(pos):
                            value = taper_values[active_taper_field]
                            if key == "DEL":
                                taper_values[active_taper_field] = value[:-1]
                            elif key == ".":
                                if "." not in value:
                                    taper_values[active_taper_field] = value + "."
                            elif len(value) < 12:
                                taper_values[active_taper_field] = value + key
                            break
                    else:
                        if taper_buttons["CLEAR"].collidepoint(pos):
                            taper_values[active_taper_field] = ""

        draw_industrial_background(screen, width, height)
        draw_wrapped_text(screen, "COMPOUND REST TAPER CALCULATOR", font_medium, YELLOW, (50, 35), keypad_x - 70)
        unit = "mm" if is_metric else "in"
        field_labels = {
            "large": f"LARGE DIAMETER ({unit})",
            "small": f"SMALL DIAMETER ({unit})",
            "length": f"AXIAL TAPER LENGTH ({unit})"
        }
        for field_name, rect in taper_fields.items():
            label = font_small.render(field_labels[field_name], True, CYAN)
            screen.blit(label, (rect.x, rect.y - 32))
            pygame.draw.rect(screen, MED_GREY, rect)
            pygame.draw.rect(screen, YELLOW if field_name == active_taper_field else WHITE, rect, 3)
            value_text = font_medium.render(taper_values[field_name] or "0", True, WHITE)
            screen.blit(value_text, value_text.get_rect(midleft=(rect.x + 20, rect.centery)))

        for key, rect in keypad_buttons.items():
            pygame.draw.rect(screen, MED_GREY, rect)
            pygame.draw.rect(screen, WHITE, rect, 2)
            label = font_medium.render(key, True, WHITE)
            screen.blit(label, label.get_rect(center=rect.center))

        clear_rect = taper_buttons["CLEAR"]
        pygame.draw.rect(screen, MED_GREY, clear_rect)
        pygame.draw.rect(screen, WHITE, clear_rect, 2)
        clear_label = font_small.render("CLEAR ACTIVE FIELD", True, WHITE)
        screen.blit(clear_label, clear_label.get_rect(center=clear_rect.center))

        if all(taper_values[name] for name in ("large", "small", "length")):
            try:
                angle = compound_rest_angle(
                    float(taper_values["large"]),
                    float(taper_values["small"]),
                    float(taper_values["length"])
                )
                angle_text = f"COMPOUND SETTING: {angle:.4f} degrees"
                angle_color = GREEN
            except ValueError as error:
                angle_text = str(error)
                angle_color = RED
        else:
            angle_text = "Enter all three dimensions"
            angle_color = WHITE
        draw_wrapped_text(screen, angle_text, font_small, angle_color, (50, 500), keypad_x - 70)
        draw_wrapped_text(screen, "Angle from spindle axis = atan(|D1 - D2| / (2 x L))", font_small, WHITE, (50, 555), keypad_x - 70)

        back_rect = taper_buttons["BACK"]
        pygame.draw.rect(screen, RED, back_rect)
        pygame.draw.rect(screen, WHITE, back_rect, 2)
        back_label = font_medium.render("BACK", True, WHITE)
        screen.blit(back_label, back_label.get_rect(center=back_rect.center))
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
