SirCrashAlot79/lathe_dro/(commit log)

2026-10-16 Separate spindle RPM display
2026-10-16 Fix text overlap on utility screens
    [lathe_dro_pro.py]
2026-10-17 Prevent text overlap on calculator screens
    [lathe_dro_pro.py]
2026-10-17 Increase main screen mode button size
2026-10-18 Add scale calibration and Raspberry Pi DRO package
2026-10-18 Correct RPM sensor wiring documentation
    [main.cpp]
2026-10-19 Update cradle and case CAD files
    [Case base.stl, Case lid.stl, Left frame.stl, Right frame.stl]
2026-10-25 Update DRO startup and thread chart
2026-10-26 Add mill DRO and machine selector
2026-10-26 Separate lathe and mill scale inputs
2026-10-26 Add mill macro tools: hole patterns, cutter offsets, calculator, sub-datums
2026-10-27 Sync Raspberry Pi DRO with mill features
2026-10-27 Clarify Raspberry Pi features in main README
